junfoot/STM32F407_Muscle/Requirements.md

参考“烧录固件引脚清单.md”，完成STM32嵌入式程序设计
- cubemx产生的ioc文件要同步更新
- 两块AD7606同步采样，量程为正负5V，采样频率2000hz
- AD7606 两片均使用 5V 模拟供电，但输入量程由 RANGE 引脚决定；当前 PC5、PD13 均为低电平，对应输入范围 -5V～+5V。串口电压按 `int16_adc × 5 / 32768` 换算。
- 开启当前连接的这块DAC
- 通过串口USART1实时发送16个通道的ADC数值
- 通过串口指令发送DAC要输出的值
- 保证各功能正常运行，不要阻塞
- 参考文件中使用了但在这没提的功能不用加
- 完成后git本地进行版本管理

补充1
- 将printf函数重定向到usart1
- DAC实际使用的【安富莱】DAC8563_DAC模块 ，输出映射到了0-10V
- 参考工程STM32F407_9011RF，集成IMU读取功能，并实时通过串口输出。这个频率应该低于ADC输出，同步到2000hz后，中间不变的值保持一样即可。一共有0-3号4颗IMU
- IMU参数发送三个角度、三个加速度即可
- 管理好优先级，一般ADC优先级会高，不要发生阻塞
- 串口下发的指令用易写的字符串形式
- USART1命令接收使用Receive-to-IDLE DMA和软件环形缓冲，避免高优先级ADC中断期间丢失字符
- 串口上传格式：采样数据解析#
数据格式#
#define CH_COUNT 通道数量
struct Frame {
    float fdata[CH_COUNT];
    unsigned char tail[4]{0x00, 0x00, 0x80, 0x7f};
};
fdata为小端浮点数组，里面放着需要发送的CH_COUNT个数据。
tail为帧尾。
发送4个曲线的数据长这个样子
bf 10 59 3f b1 02 95 3e 57 a6 16 be 7b 4d 7f bf 00 00 80 7f

补充2
- 串口显示100hz，包括sd卡与usb连接状态，dac输出值，adc采样值，imu数据；第一位状态值bit0表示检测到SD卡、bit1表示USB已连接
- 通过pa15按键控制sd卡写入，led灯指示写入状态

补充3
- 上电时只检测SD卡，不自动创建文件或开始记录
- 按下PA15按键或收到串口`REC START`命令后才开始SD卡记录
