junfoot/STM32F407_Muscle/Ref_project/STM32F407VET6_ADS1292/SD_DATA/20260916/analysis_results/report_5_7.md

# 第 5–7 组步态数据初步分析

## 数据与方法

- 第5组：平地行走；第6组：下楼梯；第7组：上楼梯。
- sEMG1/2 分别为左/右竖脊肌；IMU0/1/2 分别位于左大腿、右大腿、尾椎骨。
- 用三枚 IMU 的角速度模长和动态加速度模长联合识别持续运动区间，排除头尾静止与短促拿放冲击。绿色区域见总览图。
- 肌电采用已有 18 Hz 高通 + 50 Hz 梳状陷波结果，再计算 100 ms RMS 包络；只在自动识别的活动窗内统计。原转换流程已先删除滤波后的前 1 s，进一步减弱了零初值瞬态。
- 为降低安装轴不一致的影响，IMU 比较采用三轴向量模长、三轴协方差特征值以及各传感器自己的 PCA 主运动轴；没有把不同传感器的同名单轴直接相减。

## 自动分段与主要指标

|组别|工况|活动区间 (s)|时长 (s)|左EMG RMS (µV)|右EMG RMS (µV)|双侧差异 (%)|包络相关|步频 (步/min)|尾椎动态加速度 RMS (g)|
|---:|---|---:|---:|---:|---:|---:|---:|---:|---:|
|5|平地行走|5.1–20.3|15.2|68.5|97.0|34.3|0.53|106.2|0.229|
|6|下楼梯|3.0–10.7|7.8|27.5|32.4|16.3|0.25|98.3|0.259|
|7|上楼梯|3.2–10.5|7.3|42.7|68.6|46.4|0.01|101.5|0.242|

## 相对平地的变化

- 下楼梯：左/右竖脊肌 RMS 相对平地分别为 -59.9% / -66.6%；尾椎动态加速度 RMS 为 +12.9%。
- 上楼梯：左/右竖脊肌 RMS 相对平地分别为 -37.7% / -29.3%；尾椎动态加速度 RMS 为 +5.4%。

## 可以支持的初步结论

1. 三种任务的竖脊肌负荷、左右协同性、步频及躯干动态冲击可以进行定量比较；具体数值以上表和 CSV 为准。
2. 单轴波形不能跨 IMU 直接比较，因为安装姿态差异会把同一身体运动投影到不同轴；本分析的模长/PCA 结果更适合当前数据。
3. 大腿角速度的第一主成分方差占比可衡量运动是否近似集中在一个主旋转轴；占比高时，PCA 主轴信号可作为近似屈伸波形，但仍不是解剖学关节角。
4. 当前只有每种工况一次、同一受试者的一段记录，没有 MVC 归一化、足接触事件或安装标定，因此只能作为描述性个案结果，不能做组间统计推断，也不宜把原始 µV 直接解释为普遍的肌肉负荷大小。

## 质量控制与后续建议

- 对齐文件显示 EMG 序列连续、无缺样；但 IMU 插值最近源样本距离的最大值在部分通道达到约 0.1–0.36 s。应查看原始时间戳，把源样本距离过大的区间标为低可信，而不是把插值曲线当作真实高频采样。
- 正式采集前做 5–10 s 静止站立标定，记录每个 IMU 的安装方向；若要算髋/躯干角，建议保存四元数并用传感器到解剖坐标系的标定旋转矩阵变换。
- 增加同步脚踏开关或足部 IMU，明确脚跟着地/离地事件；每工况至少重复多次，并采集 MVC，之后可做步态周期归一化和统计检验。

## 输出文件

- `metrics_5_7.csv`：完整数值指标。
- `overview_5_7.png`：EMG 包络、三枚 IMU 角速度模长与自动活动窗。
- `analysis_parameters.json`：关键参数，便于复现。
