junfoot/STM32F407_Muscle/Ref_project/STM32F407VET6_ADS1292/SD_DATA/20260916/analysis.md

分析5-7组数据能得到什么结论
- 5：平地行走
- 6：下楼梯
- 7：上楼梯
- sEMG1：左竖脊肌（后腰）
- sEMG2：右竖脊肌（后腰）
- IMU0：左侧大腿前侧
- IMU1：右侧大腿前侧
- IMU2：尾椎骨处
- 数据头尾未在行走。肌电信号由于滤波头部有震荡
- IMU的轴可能并不是很对齐，有没有什么方法分析

## 分析进展（2026-09-16）

已完成第 5–7 组的首轮可重复分析：自动排除头尾非行走段，计算双侧竖脊肌 RMS 包络、步频、三枚 IMU 的角速度/动态加速度指标，并用三轴模长与 PCA 主运动轴降低安装轴不对齐的影响。

初步结果：

- 自动识别的主要活动窗：第5组 5.11–20.26 s，第6组 2.95–10.74 s，第7组 3.20–10.47 s。
- 步频约为 106.2、98.3、101.5 步/min（依次为平地、下楼、上楼）。
- 本次记录中，上楼的双侧竖脊肌 RMS 高于下楼，但平地最高；由于每种工况只有一次记录且没有 MVC 归一化，这一现象只能作为个案描述，不能直接外推为普遍生理结论。
- 尾椎动态加速度 RMS：下楼最高（0.259 g），上楼次之（0.242 g），平地最低（0.229 g），提示本次下楼的躯干动态冲击更大。
- IMU 不宜跨传感器直接比较同名单轴。当前采用旋转不变的三轴模长、协方差特征值和各传感器自身 PCA 主轴；若需解剖学关节角，后续必须增加静态姿态/安装方向标定。

完整结果见 [`analysis_results/report_5_7.md`](analysis_results/report_5_7.md)，数值表见 [`analysis_results/metrics_5_7.csv`](analysis_results/metrics_5_7.csv)，复现脚本为 [`analyze_gait_5_7.py`](analyze_gait_5_7.py)。

## 躯干肌电能否比下肢肌电提供更多信息？

### 结论先行

**不能根据本批数据证明“躯干肌电比下肢肌电信息更多”。** 本批实验只测了左右竖脊肌，没有同步测量任何下肢肌肉，因此缺少同一受试者、同一动作、同一步态周期下的直接对照。更准确的结论是：

- 对**躯干稳定、腰椎负荷、左右代偿、姿势控制及低背痛相关控制策略**，躯干肌电通常比下肢肌电更直接。
- 对**步态相位、足部离地/着地、髋膝踝做功、推进与制动、上/下楼意图**，多块下肢肌电通常更直接，也往往具有更高的任务识别能力。
- 若目标是理解完整步态机制，二者是**互补信息**，不存在与任务无关的绝对“谁更多”。本系统目前的两路竖脊肌 EMG 更适合作为下肢 IMU/未来下肢 EMG 的补充通道，而不是替代下肢 EMG。

### 本批数据实际支持什么

将左右竖脊肌 RMS 取算术平均后，平地、下楼、上楼分别约为 **82.7、30.0、55.7 µV**。三个任务同时呈现不同的双侧模式：

|工况|双侧平均 RMS (µV)|左右不对称 (%)|左右包络零时滞相关|骶骨动态加速度 RMS (g)|
|---|---:|---:|---:|---:|
|平地|82.7|34.3|0.53|0.229|
|下楼|30.0|16.3|0.25|0.259|
|上楼|55.7|46.4|0.01|0.242|

这里最值得关注的不是原始幅值排序，而是 **EMG 与运动冲击的排序不一致**：下楼时骶骨动态加速度最高而竖脊肌 RMS 最低，平地则相反。这说明竖脊肌 EMG 没有简单重复 IMU 的“运动强度”，而可能包含额外的神经肌肉控制信息，例如躯干刚度调节、左右稳定策略和姿势代偿。上楼时较大的左右不对称也值得复测。

不过，这些结果还不能被解释成确定的生理差异，原因包括：每个工况只有一次记录、每段时长不同、没有 MVC 归一化、没有逐步态周期对齐，也没有控制速度、扶手使用、领先腿、楼梯高度和负重。若三次记录之间重新贴过电极，原始 µV 幅值甚至不应直接跨记录比较。

另外，表中的“左右包络相关”是**零时滞相关**。上楼的 0.01 不等于左右肌肉“没有协同”；左右交替、周期相位差、少量时间错位都会显著降低该指标。正式结论应在可靠的足接触事件或步态周期基础上，计算允许时滞的互相关、周期归一化波形相似度及共同激活指数。

### 为什么两类 EMG 回答的是不同问题

|研究问题|更优先的信号|原因|
|---|---|---|
|平地/上楼/下楼识别，步态相位与运动意图|下肢多肌群 EMG|股四头肌、腘绳肌、胫前肌、腓肠肌/比目鱼肌直接参与支撑、推进、制动和摆动；楼梯上升与下降的关节功和募集模式明显不同。|
|髋、膝、踝功能障碍定位|下肢 EMG + 关节运动学/力学|能够把异常募集对应到具体关节和步态阶段。|
|躯干稳定、腰背负荷和姿势代偿|双侧/多部位躯干 EMG|竖脊肌和腹肌直接反映轴向稳定与共同收缩；单纯下肢 EMG 难以定位腰背控制策略。|
|左右躯干不对称、脊柱疾病或低背痛表型|躯干阵列 EMG|相关研究在脊柱不稳、脊柱侧弯和持续性低背痛中观察到椎旁肌幅值、时序与左右协调的改变。|
|绊倒、外扰和负重下的全身稳定反应|躯干 EMG + 下肢 EMG + IMU|躯干反射负责快速稳定上身，下肢随后通过落脚位置、支撑和推进恢复平衡。|

这也解释了当前结果为何没有呈现“上/下楼竖脊肌一定高于平地”的简单关系：楼梯任务对**下肢正/负机械功**的增加很明确，但竖脊肌幅值取决于躯干姿势、速度、个体稳定策略和测量归一化，不能用下肢做功规律直接替代。

### 怎样在下一批实验中真正比较“信息量”

建议保留当前左右竖脊肌，同时至少增加双侧以下四类下肢肌肉：股直肌或股外侧肌、股二头肌、胫骨前肌、腓肠肌内侧头或比目鱼肌。若通道有限，优先保留双侧竖脊肌，再用 4–6 个下肢通道覆盖髋/膝/踝功能，而不是只测同一关节周围的多块相近肌肉。

实验与统计应采用：

1. 每工况至少 5–10 次独立重复，记录平地、上楼、下楼、转弯、扰动/负重等任务；同步足部 IMU 或脚踏开关。
2. 电极位置按 SENIAM 思路固定并记录，采集 MVC 或任务内参考收缩，使用 `%MVC` 或每受试者稳健标准化；固定楼梯高度、速度、领先腿与是否扶扶手。
3. 以完整步态周期为样本，分别建立三组模型：`IMU`、`IMU + 下肢 EMG`、`IMU + 下肢 EMG + 躯干 EMG`。
4. 采用**按受试者/按整次试验分组的交叉验证**，禁止把同一次记录切成相邻窗口后随机分到训练集和测试集，否则会产生严重数据泄漏。
5. 用宏平均 F1、交叉熵或条件互信息衡量增益：
   - 下肢 EMG 增益：`模型(IMU+下肢) − 模型(IMU)`；
   - 躯干 EMG 的独立增益：`模型(IMU+下肢+躯干) − 模型(IMU+下肢)`。
   只有后一项在独立测试中稳定为正，才能说躯干 EMG 提供了下肢信号没有覆盖的信息；若其增益还显著大于前一项，才有依据说在**指定任务和指标下**“躯干 EMG 更多”。

### 对当前系统的判断

当前两路竖脊肌已经显示出值得保留的补充价值，尤其是左右不对称与“肌肉募集—躯干冲击”不一致的信息。但仅靠两路竖脊肌，不足以解释下肢各关节的推进、制动和做功，也不足以可靠识别完整步态相位。若研究重点是外骨骼控制或上下楼意图识别，下肢 EMG 应是优先扩展方向；若重点是腰背代偿、姿势稳定、低背痛或脊柱不对称，躯干 EMG 则可能是更有价值的主信号。

### 文献依据

- Peng 等发现进入楼梯前的下肢运动学和 EMG 已出现预期性改变，支持下肢 EMG 用于楼梯转换/意图识别：[J Biomech, 2016](https://pubmed.ncbi.nlm.nih.gov/26830440/)。
- Koopman 等对平地、楼梯及其转换的研究显示，楼梯任务的下肢关节功、做功及主要肌群 EMG 随任务和坡度系统改变：[PLOS ONE, 2023](https://pmc.ncbi.nlm.nih.gov/articles/PMC10653464/)。
- 一项包含 50 名健康受试者的公开数据研究同时采集下肢运动学、动力学和主要下肢肌群 EMG，说明这些信号适合刻画不同步行与楼梯任务：[Scientific Data, 2019](https://pmc.ncbi.nlm.nih.gov/articles/PMC6897988/)。
- Smith 等的系统综述与荟萃分析显示，持续性低背痛人群步行时椎旁肌激活幅值及躯干协调可发生改变，说明躯干 EMG 对腰背控制表型具有针对性信息：[J Sport Health Sci, 2022](https://pmc.ncbi.nlm.nih.gov/articles/PMC9338341/)。
- 突发行走扰动研究用多通道躯干 EMG 识别神经肌肉反射与姿势反应，提示躯干 EMG 对稳定性/扰动问题的价值：[Eur Spine J, 2017](https://pmc.ncbi.nlm.nih.gov/articles/PMC5358879/)。
