junfoot/STM32F407_Muscle/Ref_project/STM32F407_9011RF/9011rf.md

                                                                                                                          

# 产品介绍
## 产品概述
+ 产品模组由1个主机和若干个从机组成，最多可连接32个从机。
+ <font style="color:#181818;">从机集成高精度的陀螺仪、加速度计、地磁场传感器，采用高性能的微处理器和先进的动力学解算与卡尔曼动态滤波算法，能够快速求解出从机当前的实时运动姿态。</font>
+ <font style="color:#181818;">采用先进的数字滤波技术，能有效降低测量噪声，提高测量精度。</font>
+ <font style="color:#181818;">从机内部集成了姿态解算器，配合动态卡尔曼滤波算法，能够在动态环境下准确输出从机的当前姿态，姿态测量精度0.2度，稳定性极高，性能甚至优于某些专业的倾角仪！</font>
+ <font style="color:#181818;">高性能cortex-M4内核处理器运行主频高达168MHZ，兼顾低功耗与高性能。</font>
+ <font style="color:#181818;">射频2.4G无线传输，传输速率快，最高有效速率可达256kbps。</font>

## 产品特点
+ <font style="color:black;background-color:#FFFFFF;">从机</font><font style="color:black;background-color:#FFFFFF;">集成高精度的陀螺仪、加速度计、地磁场传感器，采用高性能的微处理器和先进的动力学解算与卡尔曼动态滤波算法，能够快速求解出模块当前的实时运动姿态。</font>
+ <font style="color:black;background-color:#FFFFFF;">采用先进的数字滤波技术，能有效降低测量噪声，提高测量精度。</font>
+ <font style="color:black;background-color:#FFFFFF;">从机</font><font style="color:black;background-color:#FFFFFF;">内部集成了姿态解算器，配合动态卡尔曼滤波算法，能够在动态环境下准确输出模块的当前姿态，姿态测量精度0.2°，稳定性极高，性能甚至优于某些专业的倾角仪。</font>
+ <font style="color:black;background-color:#FFFFFF;">Z轴航向角加入地磁传感器滤波融合，解决了6轴算法中，由于陀螺仪积分的漂移引起的累计误差，可长期稳定输出航向角数据。</font>**<font style="color:black;background-color:#FFFFFF;">注意：要由于有磁场检测，使用前需要校准，而且使用时需要远离磁干扰区域、电子设备、磁铁、扬声器等硬磁性物体至少20cm的距离。</font>**
+ <font style="color:rgb(24, 24, 24);">工作电流：≈  15mA，待机电流  13uA。</font>
+ <font style="color:rgb(24, 24, 24);">数据接口：波特率460800。</font>
+ <font style="color:black;background-color:#FFFFFF;">输出内容包含三轴加速度、三轴角速度、三轴磁场、三轴角度、从机电量</font><font style="color:#181818;">。</font>
+ <font style="color:black;background-color:#FFFFFF;">4层PCB板工艺，更薄、更小、更可靠。</font>
+ <font style="color:#181818;">2.4G射频无线传输</font>

# <font style="color:black;background-color:#FFFFFF;">参数指标</font>
## <font style="color:black;background-color:#FFFFFF;">加速度计参数</font>
| 参数 | 条件 | 典型值 |
| :---: | --- | :---: |
| 量程 |  | ±16g |
| 分辨率 | ±16g | 0.0005(g/LSB) |
| 采样率 |  | 1KHZ |
| RMS噪声 | 带宽=100Hz | 0.75~1mg-rms |
| 静止零漂 | 水平放置 | ±20~40mg |
| 温漂 | -40°C ~ +85°C | ±0.15mg/℃ |
| 带宽 |  | 5~256Hz |

## 陀螺仪参数
| 参数 | 条件 | 典型值 |
| :---: | :---: | :---: |
| 量程 |  | ±2000°/s |
| 分辨率 | ±2000°/s | 0.061(°/s)/(LSB) |
| 采样率 |  | 1KHZ |
| RMS噪声 | 带宽=100Hz | 0.028~0.07(°/s)-rms |
| 静止零漂 | 水平放置 | ±0.5~1°/s |
| 温漂 | -40°C ~ +85°C | ±0.005~0.015 (°/s)/℃ |
| 带宽 |  | 5~256Hz |

## 磁力计参数
| 参数 | 条件 | 典型值 |
| :---: | :---: | :---: |
| 量程 |  | ±2Gauss |
| 分辨率 | ±2Gauss | 0.0667mGauss/LSB |

## 俯仰、横滚角参数
| 参数 | 条件 | 典型值 |
| :---: | :---: | :---: |
| 量程 |  | X:±180° |
| | | Y:±90° |
| 倾角精度 |  | 0.2° |
| 分辨率 | 水平放置 | 0.0055° |
| 温漂 | -40°C ~ +85°C | ±1° |

## 航向角参数
| 参数 | 条件 | 典型值 |
| :---: | :---: | :---: |
| 量程 | | Z:±180° |
| 航向精度 | 9轴算法，磁场校准，动/静态 | 1°（不受磁场干扰情况下）【1】 |
| | 6轴算法，静态 | 0.5°（动态存在积分累计误差）<br/>【2】 |
| 分辨率 | 水平放置 | 0.0055° |

注：

【1】使用前请在测试的环境进行磁场校准，确保传感器熟悉该环境下的磁场，校准时，请远离磁干扰【2】在有些震动环境下，会有累计误差，具体误差不可估计，具体根据实际测试为准

## 模组参数
### 基本参数
| <font style="color:black;">参数</font> | <font style="color:black;">条件</font> | <font style="color:black;">最小值</font> | <font style="color:black;">默认</font> | <font style="color:black;">最大值</font> |
| :---: | --- | --- | --- | :---: |
| <font style="color:black;">通信接口</font> | <font style="color:black;">UART</font> | <font style="color:black;">460800bps</font> | <font style="color:black;">460800bps</font> | <font style="color:black;">460800bps</font> |
| <font style="color:black;">输出内容</font> |  | <font style="color:black;">3轴加速度、3轴角速度、3轴磁场、3轴角度</font> | | |
| <font style="color:black;">输出速率</font> | 连接10个以内 | <font style="color:black;"></font> | <font style="color:black;">30HZ</font> | <font style="color:black;"></font> |
| <font style="color:black;">启动时间</font> |  |  |  | <font style="color:black;">1000ms</font> |
| <font style="color:black;">级联数量</font> | <font style="color:black;">射频</font><font style="color:black;">多联适配器</font> | 1 | 16 | <font style="color:black;">32个</font> |
| <font style="color:#181818;">无线</font><font style="color:#181818;">传输距离</font> | <font style="color:#181818;">空旷环境</font> |  | <font style="color:black;">50m</font> | <font style="color:black;">90m</font> |
| <font style="color:#181818;">重量</font> | <font style="color:#181818;"></font> |  | <font style="color:black;">8.67g</font> | <font style="color:black;"></font> |
| <font style="color:black;">工作温度</font> |  | <font style="color:black;">-20</font><font style="color:black;">℃</font> |  | <font style="color:black;">60</font><font style="color:black;">℃</font> |
| <font style="color:#4d4d4d;">存储温度</font> |  | <font style="color:#4d4d4d;">-40</font><font style="color:black;">℃</font> |  | <font style="color:#4d4d4d;">85</font><font style="color:black;">℃</font> |
| <font style="color:black;">耐冲击</font> |  |  |  | <font style="color:black;">20000g</font> |

### 电气参数
| 参数 | 条件 | 最小值 | 默认 | 最大值 |
| :---: | :---: | --- | :---: | :---: |
| 充电电压 |  |  | 5V |  |
| 电池电压 |  |  | 3.7V |  |
| 工作电流 |  |  | 15mA |  |
| 广播电流 |  |  |  |  |
| 待机电流 |  |  | 13uA |  |
| 电池容量 |  |  | 130mAH |  |
| 功耗 |  |  | 55.5mW |  |
| 工作时长 |  |  |  | 8小时 |
| 充电时长 |  |  |  | 2小时 |

# 上位机连接
## <font style="color:rgb(51, 51, 51);">CH340驱动安装 </font>
<font style="color:rgb(51, 51, 51);">通过Type-c连接上电脑，打开上位机，安装好串口模块对应的CH340驱动(</font>[CH340驱动下载](https://witpic-1253369323.cos.ap-guangzhou.myqcloud.com/soft/CH340%E9%A9%B1%E5%8A%A8.rar)<font style="color:rgb(51, 51, 51);">)以后，可以在设备管理器中查询到对应的端口号，如图所示：</font>

## 适配器连接与配置
1.先把适配器跟电脑进行连接（只有适配器需要直连电脑）



2.<font style="color:rgb(51, 51, 51);">打开维特</font>[**智能上位机**](https://wit-motion.yuque.com/wumwnr/aqvq6y/qngktvx5grz81zkq)<font style="color:rgb(51, 51, 51);">软件。</font>

①<font style="color:rgb(51, 51, 51);">选择WT9011DCL-RF的型号。</font>

<font style="color:rgb(51, 51, 51);">②点击搜索设备。</font>

<font style="color:rgb(51, 51, 51);">③勾选Master连接适配器。</font>

<font style="color:rgb(51, 51, 51);">④打开配置界面。</font>

<font style="color:rgb(51, 51, 51);">⑤确认配置界面是否“在线”，“在线”的情况下进行下一步。</font>

<font style="color:rgb(51, 51, 51);">⑥修改主机配置的从机数量，Master配置的从机数量可以大于实际要连接的从机数量，假如只有2个从机，从机数量可以配置为6或者大于6~32的任意数字，但不能低于6，假如有10个从机，从机数量可以配置为10。</font>

<font style="color:rgb(51, 51, 51);">⑦设置保存。</font>



## 从机连接与配置
1.从机按开机键进行开机，开机后会闪烁绿灯，如果开机指示灯没有反应请充电后再试。

<font style="color:#DF2A3F;">注：第1次使用的时候从机单个开机依次进行配置，不要一次性把所有从机都开机，不然无法进行配置。</font>



<font style="color:rgb(51, 51, 51);">2.打开维特</font>[**智能上位机**](https://wit-motion.yuque.com/wumwnr/aqvq6y/qngktvx5grz81zkq)<font style="color:rgb(51, 51, 51);">软件。</font>

①<font style="color:rgb(51, 51, 51);">选择WT9011DCL-RF的型号。</font>

<font style="color:rgb(51, 51, 51);">②点击搜索设备。</font>

<font style="color:rgb(51, 51, 51);">③勾选Master连接适配器。</font>

<font style="color:rgb(51, 51, 51);">④勾选从机。</font>

<font style="color:rgb(51, 51, 51);">⑤第1次连接的时候，所有从机ID都是01，所以第1次配置时只勾选01的从机ID，然后打开配置界面。</font>

<font style="color:rgb(51, 51, 51);">⑥确认配置界面是否“在线”，“在线”的情况下进行下一步。</font>

<font style="color:rgb(51, 51, 51);">⑦连接多个从机的时候，需要修改默认ID，ID配置范围0~31，即00、01、02......30、31。</font>

<font style="color:#DF2A3F;">注：搜索设备会出现多个设备选项，只需要关注id为01的设备即可，所有从机出厂时设备id默认都为01。</font>



⑧配置其他从机重复①-⑦步骤，再进行第2个从机配置时同样勾选01进行配置，修改设备ID即可。

⑨配置好所有从机后重新进行搜索，勾选Master和相应从机ID就可以显示数据。

# 产品尺寸



# 接口定义
## 接口说明
| 接口名称 | | 接口功能 |
| :---: | --- | :---: |
| <font style="color:black;">主机</font><font style="color:black;">TYPE-C</font> | | <font style="color:black;">充电及串口输出</font><font style="color:black;">【1】</font> |
| <font style="color:black;">从机TYPE-C</font> | | <font style="color:black;">充电</font> |

注：

【1】支持TYPE-C连接PC查看数据，PC端需要安装CH340驱动。

# 产品包装
## 样品包装



# <font style="color:black;background-color:#FFFFFF;">应用领域</font>
+ <font style="color:black;background-color:#FFFFFF;">虚拟现实/增强现实，头戴显示器</font>
+ <font style="color:black;background-color:#FFFFFF;">大规模农业自动耕种</font>
+ <font style="color:black;background-color:#FFFFFF;">高空作业安全监控</font>
+ <font style="color:black;background-color:#FFFFFF;">工业姿态监控</font>
+ <font style="color:black;background-color:#FFFFFF;">人体动作跟踪/捕捉</font>
+ <font style="color:black;background-color:#FFFFFF;">机器人，自动引导运输车</font>
+ <font style="color:black;background-color:#FFFFFF;">行人导航</font>
+ <font style="color:black;background-color:#FFFFFF;">无人驾驶/辅助驾驶</font>

##
