junfoot/STM32F407_Muscle/Ref_project/STM32F407_9011RF/9011RF通讯协议.md

# <font style="color:rgb(0,0,0);">RF传输模式</font>
从机——>主机		（射频信号传输）

主机——>上位机	（串口传输）

**<font style="color:rgb(0,0,0);">主机到上位机默认上传 Flag=0x61(加速度 角速度 磁场 角度 电量)的数据。 </font>**

**<font style="color:rgb(0,0,0);">Flag=0x71 需要发送读取对应寄存器指令才能回传。 </font>**

**<font style="color:rgb(0,0,0);"></font>**

# <font style="color:rgb(0,0,0);">加速度 角速度 磁场 角度 电量数据包（默认）</font>
| 设备号<br/><font style="color:rgb(0,0,0);">1Byte</font> | <font style="color:rgb(0,0,0);">数据包头 </font><br/><font style="color:rgb(0,0,0);">1Byte</font> | <font style="color:rgb(0,0,0);">标志位 </font><br/><font style="color:rgb(0,0,0);">1Byte</font> | <font style="color:rgb(0,0,0);">axL</font> | <font style="color:rgb(0,0,0);">axH</font> | ...... | <font style="color:rgb(0,0,0);">YawL</font> | <font style="color:rgb(0,0,0);">YawH</font> | <font style="color:rgb(0,0,0);">BatPerL</font> | <font style="color:rgb(0,0,0);">BatPerH</font> |
| --- | --- | --- | --- | --- | --- | --- | --- | --- | --- |
| 0xNN | <font style="color:rgb(0,0,0);">0x55</font> | Flag | 0xNN | 0xNN | ...... | 0xNN | 0xNN | 0xNN | 0xNN |

<font style="color:rgb(0,0,0);">注：0xNN 是收到的具体数值,数据回传顺序为加速度 X Y Z，角速度 X Y Z,磁场 XYZ, 角度 XYZ, 电池电量</font>

<font style="color:rgb(0,0,0);">低字节在前，高字节在后。 </font>

<font style="color:rgb(0,0,0);">Flag = 0x61 数据内容 26Bytes 为加速度，角速度,  磁场，角度, 电池电量</font>

| <font style="color:rgb(0,0,0);">0xNN</font> | 设备号 |
| --- | --- |
| <font style="color:rgb(0,0,0);">0x55 </font> | <font style="color:rgb(0,0,0);">数据包头</font> |
| <font style="color:rgb(0,0,0);">0x61 </font> | <font style="color:rgb(0,0,0);">标志位 </font> |
| <font style="color:rgb(0,0,0);">axL </font> | <font style="color:rgb(0,0,0);">X 轴加速度低 8 位 </font> |
| <font style="color:rgb(0,0,0);">axH </font> | <font style="color:rgb(0,0,0);">X 轴加速度高 8 位 </font> |
| <font style="color:rgb(0,0,0);">ayL </font> | <font style="color:rgb(0,0,0);">Y 轴加速度低 8 位</font> |
| <font style="color:rgb(0,0,0);">ayH </font> | <font style="color:rgb(0,0,0);">Y 轴加速度高 8 位</font> |
| <font style="color:rgb(0,0,0);">azL </font> | <font style="color:rgb(0,0,0);">Z 轴加速度低 8 位</font> |
| <font style="color:rgb(0,0,0);">azH </font> | <font style="color:rgb(0,0,0);">Z 轴加速度高 8 位 </font> |
| <font style="color:rgb(0,0,0);">wxL </font> | <font style="color:rgb(0,0,0);">X 轴角速度低 8 位 </font> |
| <font style="color:rgb(0,0,0);">wxH</font> | <font style="color:rgb(0,0,0);">X 轴角速度高 8 位</font> |
| <font style="color:rgb(0,0,0);">wyL </font> | <font style="color:rgb(0,0,0);">Y 轴角速度低 8 位</font> |
| <font style="color:rgb(0,0,0);">wyH</font> | <font style="color:rgb(0,0,0);">Y 轴角速度高 8 位</font> |
| <font style="color:rgb(0,0,0);">wzL </font> | <font style="color:rgb(0,0,0);">Z 轴角速度低 8 位</font> |
| <font style="color:rgb(0,0,0);">wzH </font> | <font style="color:rgb(0,0,0);">Z 轴角速度高 8 位</font> |
| <font style="color:rgb(0,0,0);">hxL </font> | <font style="color:rgb(0,0,0);">X 轴磁场低 8 位 </font> |
| <font style="color:rgb(0,0,0);">hxH</font> | <font style="color:rgb(0,0,0);">X 轴磁场高 8 位</font> |
| <font style="color:rgb(0,0,0);">hyL </font> | <font style="color:rgb(0,0,0);">Y 轴磁场低 8 位</font> |
| <font style="color:rgb(0,0,0);">hyH</font> | <font style="color:rgb(0,0,0);">Y 轴磁场高 8 位</font> |
| <font style="color:rgb(0,0,0);">hzL </font> | <font style="color:rgb(0,0,0);">Z 轴磁场低 8 位</font> |
| <font style="color:rgb(0,0,0);">hzH </font> | <font style="color:rgb(0,0,0);">Z 轴磁场高 8 位</font> |
| <font style="color:rgb(0,0,0);">RollL </font> | <font style="color:rgb(0,0,0);">X 轴角度低 8 位</font> |
| <font style="color:rgb(0,0,0);">RollH </font> | <font style="color:rgb(0,0,0);">X 轴角度高 8 位</font> |
| <font style="color:rgb(0,0,0);">PitchL</font> | <font style="color:rgb(0,0,0);">Y 轴角度低 8 位 </font> |
| <font style="color:rgb(0,0,0);">PitchH </font> | <font style="color:rgb(0,0,0);">Y 轴角度高 8 位</font> |
| <font style="color:rgb(0,0,0);">YawL</font> | <font style="color:rgb(0,0,0);">Z 轴角度低 8 位</font> |
| <font style="color:rgb(0,0,0);">YawH </font> | <font style="color:rgb(0,0,0);">Z 轴角度高 8 位</font> |
| <font style="color:rgb(0,0,0);">BatPerL</font> | <font style="color:rgb(0,0,0);">从机电池电量低八位</font> |
| <font style="color:rgb(0,0,0);">BatPerH</font> | <font style="color:rgb(0,0,0);">从机电池电量高八位</font> |

### <font style="color:rgb(0,0,0);">加速度计算方法：单位 g </font>
<font style="color:rgb(0,0,0);">a</font><font style="color:rgb(0,0,0);">x</font><font style="color:rgb(0,0,0);">=((axH<<8)|axL)/32768*16g(g </font><font style="color:rgb(0,0,0);">为重力加速度，可取 </font><font style="color:rgb(0,0,0);">9.8m/s</font><font style="color:rgb(0,0,0);">2</font><font style="color:rgb(0,0,0);">) </font>

<font style="color:rgb(0,0,0);">a</font><font style="color:rgb(0,0,0);">y</font><font style="color:rgb(0,0,0);">=((ayH<<8)|ayL)/32768*16g(g </font><font style="color:rgb(0,0,0);">为重力加速度，可取 </font><font style="color:rgb(0,0,0);">9.8m/s</font><font style="color:rgb(0,0,0);">2</font><font style="color:rgb(0,0,0);">) </font>

<font style="color:rgb(0,0,0);">a</font><font style="color:rgb(0,0,0);">z</font><font style="color:rgb(0,0,0);">=((azH<<8)|azL)/32768*16g(g </font><font style="color:rgb(0,0,0);">为重力加速度，可取 </font><font style="color:rgb(0,0,0);">9.8m/s</font><font style="color:rgb(0,0,0);">2</font><font style="color:rgb(0,0,0);">) </font>

<font style="color:rgb(0,0,0);"></font>

### <font style="color:rgb(0,0,0);">角速度计算方法：单位 °/s</font>
<font style="color:rgb(0,0,0);">w</font><font style="color:rgb(0,0,0);">x</font><font style="color:rgb(0,0,0);">=((wxH<<8)|wxL)/32768*2000(°/s) </font>

<font style="color:rgb(0,0,0);">w</font><font style="color:rgb(0,0,0);">y</font><font style="color:rgb(0,0,0);">=((wyH<<8)|wyL)/32768*2000(°/s) </font>

<font style="color:rgb(0,0,0);">w</font><font style="color:rgb(0,0,0);">z</font><font style="color:rgb(0,0,0);">=((wzH<<8)|wzL)/32768*2000(°/s) </font>

<font style="color:rgb(0,0,0);"></font>

### <font style="color:rgb(0,0,0);">角度计算方法：单位 ° </font>
<font style="color:rgb(0,0,0);">滚转角（x 轴）Roll=((RollH<<8)|RollL)/32768*180(°) </font>

<font style="color:rgb(0,0,0);">俯仰角（y 轴）Pitch=((PitchH<<8)|PitchL)/32768*180(°) </font>

<font style="color:rgb(0,0,0);">偏航角（z 轴）Yaw=((YawH<<8)|YawL)/32768*180(°) </font>

<font style="color:rgb(0,0,0);"></font>

### <font style="color:rgb(0,0,0);">磁场输出：单位uT</font>
注：原始数据计算得出来的磁场数据单位是毫高斯，和电脑上位机显示的单位是不一样的，<font style="color:#DF2A3F;">如果需要转换和上位机一样的单位需要根据下面这个计算方式去计算。</font>

**1.**[**磁场原始数据单位转换公式链接**](https://wit-motion.yuque.com/wumwnr/docs/ggh1nyqhkg0gyk43?singleDoc#)

| <font style="color:rgb(0,0,0);">0x55 </font> | <font style="color:rgb(0,0,0);">0x71</font> | <font style="color:rgb(0,0,0);">0x3A </font> | <font style="color:rgb(0,0,0);">0x00 </font> | <font style="color:rgb(0,0,0);">HxL </font> | <font style="color:rgb(0,0,0);">HxH</font> | <font style="color:rgb(0,0,0);">HyL </font> | <font style="color:rgb(0,0,0);">HyH </font> | <font style="color:rgb(0,0,0);">HzL </font> | <font style="color:rgb(0,0,0);">HzH.....</font> |
| --- | --- | --- | --- | --- | --- | --- | --- | --- | --- |

<font style="color:rgb(0,0,0);">计算方法：单位 </font><font style="color:rgb(0,0,0);">mG </font>

<font style="color:rgb(0,0,0);">磁场（x 轴）Hx=(( HxH<<8)| HxL) </font>

<font style="color:rgb(0,0,0);">磁场（y 轴）Hy=(( HyH <<8)| HyL) </font>

<font style="color:rgb(0,0,0);">磁场（z 轴）Hz =(( HzH<<8)| HzL) </font>

<font style="color:rgb(0,0,0);">例：在 </font><font style="color:rgb(0,0,0);">APP </font><font style="color:rgb(0,0,0);">上发送读取磁场指令：</font><font style="color:rgb(0,0,0);">FF AA 27 3A 00</font><font style="color:rgb(0,0,0);">（参考 </font><font style="color:rgb(0,0,0);">7.2.8 </font><font style="color:rgb(0,0,0);">读取寄存器值） </font>

<font style="color:rgb(0,0,0);">模块回传数据至 APP：55 71 3A 00 68 01 69 00 7A 00 00 00 00 00 00 00 00 00 00 00 共 20 个字节。</font>

<font style="color:rgb(0,0,0);">对第 5 至第 10 个字节按上述解算,磁场 x=360，y=105,z=122。</font>

<font style="color:rgb(0,0,0);"></font>

### <font style="color:rgb(0,0,0);">电量输出：单位V</font>
<font style="color:rgb(0,0,0);">电压和电量百分比对应关系为：</font>

| 寄存器值 | 电压值 | 电量百分比 |
| --- | --- | --- |
| >396 | > 3.96V | 100% |
| 393-396 | 3.93V-3.96V | 90% |
| 387-393 | 3.87V-3.93V | 75% |
| 382-387 | 3.82V-3.87V | 60% |
| 379-382 | 3.79V-3.82V | 50% |
| 377-379 | 3.77V-3.79V | 40% |
| 373-377 | 3.73V-3.77V | 30% |
| 370-373 | 3.70V-3.73V | 20% |
| 368-370 | 3.68V-3.70V | 15% |
| 350-368 | 3.50V-3.68V | 10% |
| 340-350 | 3.40V-3.50V | 5% |
| <340 | <3.40V | 0% |

<font style="color:rgb(0,0,0);"></font>

<font style="color:rgb(0,0,0);"></font>

<font style="color:rgb(0,0,0);">注：</font>

<font style="color:rgb(0,0,0);">1. 姿态角结算时所使用的坐标系为东北天坐标系，正方向放置模块,如“4 引脚说明” </font>

<font style="color:rgb(0,0,0);">所示向左为 X 轴，向前为 Y 轴，向上为 Z 轴。欧拉角表示姿态时的坐标系旋转顺序 </font>

<font style="color:rgb(0,0,0);">定义为为 Z-Y-X,即先绕 Z 轴转，再绕 Y 轴转，再绕 X 轴转。 </font>

<font style="color:rgb(0,0,0);">2. 滚转角的范围虽然是±180 度，但实际上由于坐标旋转顺序是 Z-Y-X，在表示姿态 </font>

<font style="color:rgb(0,0,0);">的时候，俯仰角(Y 轴)的范围只有±90 度，超过 90 度后会变换到小于 90 度，同时 </font>

<font style="color:rgb(0,0,0);">让X轴的角度大于180度。详细原理请大家自行百度欧拉角及姿态表示的相关信息。 </font>

<font style="color:rgb(0,0,0);">3. 由于三轴是耦合的，只有在小角度的时候会表现出独立变化，在大角度的时候姿态 </font>

<font style="color:rgb(0,0,0);">角度会耦合变化，比如当 Y 轴接近 90 度时，即使姿态只绕 Y 轴转动，X 轴的角度 </font>

<font style="color:rgb(0,0,0);">也会跟着发生较大变化，这是欧拉角表示姿态的固有特性。 </font>

<font style="color:rgb(0,0,0);"></font>

<font style="color:rgb(0,0,0);">说明： </font>

<font style="color:rgb(0,0,0);">1</font><font style="color:rgb(0,0,0);">、 数据是按照 </font><font style="color:rgb(0,0,0);">16 </font><font style="color:rgb(0,0,0);">进制方式发送的，不是 </font><font style="color:rgb(0,0,0);">ASCII </font><font style="color:rgb(0,0,0);">码。 </font>

<font style="color:rgb(0,0,0);">2</font><font style="color:rgb(0,0,0);">、 每个数据分低字节和高字节依次传送，二者组合成一个有符号的 </font><font style="color:rgb(0,0,0);">short</font><font style="color:rgb(0,0,0);">类型的数据。 </font>

<font style="color:rgb(0,0,0);">例如 </font><font style="color:rgb(0,0,0);">X </font><font style="color:rgb(0,0,0);">轴加速度数据 </font><font style="color:rgb(0,0,0);">Ax</font><font style="color:rgb(0,0,0);">，其中 </font><font style="color:rgb(0,0,0);">AxL </font><font style="color:rgb(0,0,0);">为低字节，</font><font style="color:rgb(0,0,0);">AxH </font><font style="color:rgb(0,0,0);">为高字节。转换方法如下： </font>

<font style="color:rgb(0,0,0);">假设 Data 为实际的数据，DataH 为其高字节部分，DataL 为其低字节部分， 那么： Data=((short)DataH<<8)|DataL。这里一定要注意 DataH 需要先强制转换为一个有符号的 short </font>

<font style="color:rgb(0,0,0);">类型的数据以后再移位，并且 </font><font style="color:rgb(0,0,0);">Data </font><font style="color:rgb(0,0,0);">的数据类型也是有符号的 </font><font style="color:rgb(0,0,0);">short </font><font style="color:rgb(0,0,0);">类型，这样才能表示出 </font>

<font style="color:rgb(0,0,0);">负数。</font>

# <font style="color:rgb(0,0,0);">单次回传寄存器的数据包</font>
<font style="color:rgb(0,0,0);">单次回传的数据包需要先发送读取寄存器指令，指令格式如下：</font>

## <font style="color:rgb(0,0,0);">1、上位机至主机</font>
| <font style="color:rgb(0,0,0);">FF  AA  27  XX  00</font> |
| :---: |

<font style="color:rgb(0,0,0);">--XX 指的是对应寄存器编号，寄存器的编号数值参考，发送指令示例如下：</font>

| <font style="color:rgb(0,0,0);">功能 </font> | <font style="color:rgb(0,0,0);">指令 </font> |
| --- | --- |
| <font style="color:rgb(0,0,0);">读 取 从 机 数 量</font> | <font style="color:rgb(0,0,0);">FF AA 27 05 00 </font> |

<font style="color:rgb(0,0,0);">发送此指令后，模块会回传一次 0x55 0x71 开头的数据包，内有对应开始寄存器地址 数据、开始寄存器地址开始以及后面 7 个寄存器数据(固定上传 8 个寄存器），回传数据格式如下：</font>

<font style="color:rgb(0,0,0);">开始寄存器（2Byte）+寄存器数据(16Byte,8 个寄存器)</font>

| <font style="color:rgb(0,0,0);">包头 </font><br/><font style="color:rgb(0,0,0);"></font><br/> | <font style="color:rgb(0,0,0);">标志 </font> | <font style="color:rgb(0,0,0);">开始寄存器地址低位 </font> | <font style="color:rgb(0,0,0);">开始寄存器地址高位</font> | <font style="color:rgb(0,0,0);">开始（第1个)寄存器数据低位 </font> | <font style="color:rgb(0,0,0);">开（第1个)寄存器数高位 </font> | ...... | <font style="color:rgb(0,0,0);">第8个寄存器数据低位</font> | <font style="color:rgb(0,0,0);">第8个寄存器数据高位</font> |
| --- | --- | --- | --- | --- | --- | --- | --- | --- |
| <font style="color:rgb(0,0,0);">0x55 </font> | <font style="color:rgb(0,0,0);">0x71 </font> | <font style="color:rgb(0,0,0);">RegL</font> | <font style="color:rgb(0,0,0);">RegH </font> | <font style="color:rgb(0,0,0);">0xNN </font> | <font style="color:rgb(0,0,0);">0xNN</font> | <font style="color:rgb(0,0,0);">...... </font> | <font style="color:rgb(0,0,0);">0xNN </font> | <font style="color:rgb(0,0,0);">0xNN</font> |

例如：55 71 05 00 06 00 00 00 00 00 00 00 00 00 00 00 00 00 00 00

得到当前可读取从机数量 6

<font style="color:rgb(0,0,0);">注：0xNN 是收到的具体数值，低字节在前，高字节在后。</font>

## <font style="color:rgb(0,0,0);">2、上位机至从机</font>
| <font style="color:rgb(0,0,0);">FF  BB  **  27  XX  00</font> |
| :---: |

--<font style="color:rgb(0,0,0);">**  指的是对应从机设备号，</font>

<font style="color:rgb(0,0,0);">--XX 指的是对应寄存器编号，寄存器的编号数值参考，发送指令示例如下：</font>

| <font style="color:rgb(0,0,0);">功能 </font> | <font style="color:rgb(0,0,0);">指令 </font> |
| --- | --- |
| <font style="color:rgb(0,0,0);">读 取 01 设 备 当 前 算 法</font> | <font style="color:rgb(0,0,0);">FF BB 01 27 24 00 </font> |
| <font style="color:rgb(0,0,0);">读 取 02 设 备 当 前 带 宽</font> | <font style="color:rgb(0,0,0);">FF BB 02 27 1f 00 </font> |
| <font style="color:rgb(0,0,0);">读 取 03 设 备  安 装 方 向 </font> | <font style="color:rgb(0,0,0);">FF BB 03 27 23 00 </font> |

<font style="color:rgb(0,0,0);">发送此指令后，模块会回传一次 0xNN 0x55 0x71 开头的数据包，内有对应开始寄存器地址 数据、开始寄存器地址开始以及后面 7 个寄存器数据(固定上传 8 个寄存器），回传数据格式如下：</font>

<font style="color:rgb(0,0,0);">开始寄存器（2Byte）+寄存器数据(16Byte,8 个寄存器)</font>

| 从机号 | <font style="color:rgb(0,0,0);">包头 </font><br/><font style="color:rgb(0,0,0);"></font><br/> | <font style="color:rgb(0,0,0);">标志 </font> | <font style="color:rgb(0,0,0);">开始寄存器地址低位 </font> | <font style="color:rgb(0,0,0);">开始寄存器地址高位</font> | <font style="color:rgb(0,0,0);">开始（第1个)寄存器数据低位 </font> | <font style="color:rgb(0,0,0);">开（第1个)寄存器数高位 </font> | <font style="color:rgb(0,0,0);">......</font> | <font style="color:rgb(0,0,0);">第8个寄存器数据低位</font> | <font style="color:rgb(0,0,0);">第8个寄存器数据高位</font> |
| --- | --- | --- | --- | --- | --- | --- | --- | --- | --- |
| 0xNN | <font style="color:rgb(0,0,0);">0x55 </font> | <font style="color:rgb(0,0,0);">0x71 </font> | <font style="color:rgb(0,0,0);">RegL</font> | <font style="color:rgb(0,0,0);">RegH </font> | <font style="color:rgb(0,0,0);">0xNN </font> | <font style="color:rgb(0,0,0);">0xNN</font> | <font style="color:rgb(0,0,0);">...... </font> | <font style="color:rgb(0,0,0);">0xNN </font> | <font style="color:rgb(0,0,0);">0xNN</font> |

<font style="color:rgb(0,0,0);">注：0xNN 是收到的具体数值，低字节在前，高字节在后。</font>

<font style="color:rgb(0,0,0);"></font>

# <font style="color:rgb(0,0,0);">上位机设置模块的指令</font>
<font style="color:rgb(0,0,0);">上位机设置模块的指令，指令格式如下：</font>

## <font style="color:rgb(0,0,0);">上位机至主机</font>
## 发送指令：
### 读取寄存器值
| FF AA 27 XX 00 | 读取寄存器值 |
| --- | --- |

<font style="color:rgb(0,0,0);">--XX 指的是对应寄存器。</font>

<font style="color:rgb(0,0,0);">发送此指令后，模块会回传一次 0x55 0x71 开头的数据包，内有对应开始寄存器地址 数据、开始寄存器地址开始以及后面 7 个寄存器数据(固定上传 8 个寄存器）</font>

### <font style="color:rgb(0,0,0);">设置从机数量</font>
| <font style="color:rgb(0,0,0);">FF AA 05 XX 00 </font> | <font style="color:rgb(0,0,0);">设置从机数量</font> |
| --- | --- |

<font style="color:rgb(0,0,0);">--XX 指的是设置的从机数量，可设置0x06~0x20。</font>

### 保存配置
| <font style="color:rgb(0,0,0);">FF AA 00 SAVE 00 </font> | <font style="color:rgb(0,0,0);">保存配置</font> |
| --- | --- |

<font style="color:rgb(0,0,0);">SAVE</font><font style="color:rgb(0,0,0);">：设置 </font>

<font style="color:rgb(0,0,0);">0</font><font style="color:rgb(0,0,0);">：保存当前配置 </font>

<font style="color:rgb(0,0,0);">1：恢复默认配置并保存</font>

<font style="color:rgb(0,0,0);"></font>

### <font style="color:rgb(0,0,0);">版本号输出</font>
| <font style="color:rgb(0,0,0);">0x55 </font> | <font style="color:rgb(0,0,0);">0x71 </font> | <font style="color:rgb(0,0,0);">0x2E</font> | <font style="color:rgb(0,0,0);">0x00 </font> | <font style="color:rgb(0,0,0);">Version1L</font> | <font style="color:rgb(0,0,0);">Version1H</font> | <font style="color:rgb(0,0,0);">......</font> |
| --- | --- | --- | --- | --- | --- | --- |
| <font style="color:rgb(0,0,0);">0x55 </font> | <font style="color:rgb(0,0,0);">0x71 </font> | <font style="color:rgb(0,0,0);">0x2F</font> | <font style="color:rgb(0,0,0);">0x00 </font> | <font style="color:rgb(0,0,0);">Version2L</font> | <font style="color:rgb(0,0,0);">Version2H</font> | <font style="color:rgb(0,0,0);">......</font> |

<font style="color:rgb(0,0,0);">版本号计算公式： </font>

<font style="color:rgb(0,0,0);">Version1=((Version1H<<8)|VersionL1) </font>

<font style="color:rgb(0,0,0);">VERSION=Version1.Version2H.Version2L  </font>

## <font style="color:rgb(0,0,0);">上位机至从机</font>
## 发送指令：
### 读取寄存器值
| FF BB ** 27 XX 00 | 读取寄存器值 |
| --- | --- |

--<font style="color:rgb(0,0,0);">**  指的是对应从机设备号，</font>

<font style="color:rgb(0,0,0);">--XX 指的是对应寄存器。</font>

<font style="color:rgb(0,0,0);">发送此指令后，模块会回传一次 0xNN 0x55 0x71 开头的数据包，内有对应开始寄存器地址 数据、开始寄存器地址开始以及后面 7 个寄存器数据(固定上传 8 个寄存器）</font>

<font style="color:rgb(0,0,0);"></font>

### <font style="color:rgb(0,0,0);">修改从机ID</font>
| <font style="color:rgb(0,0,0);">FF BB ** 1A XX 00 </font> | <font style="color:rgb(0,0,0);">修改从机ID</font> |
| --- | --- |

<font style="color:rgb(0,0,0);">--**  指的是当前的从机ID，</font>

<font style="color:rgb(0,0,0);">--XX 指的是设置的从机ID，可设置0x00~0x20。</font>

<font style="color:rgb(0,0,0);"></font>

### <font style="color:rgb(0,0,0);">版本号输出</font>
| 0xNN | <font style="color:rgb(0,0,0);">0x55 </font> | <font style="color:rgb(0,0,0);">0x71 </font> | <font style="color:rgb(0,0,0);">0x2E</font> | <font style="color:rgb(0,0,0);">0x00 </font> | <font style="color:rgb(0,0,0);">Version1L</font> | <font style="color:rgb(0,0,0);">Version1H</font> | <font style="color:rgb(0,0,0);">......</font> |
| --- | --- | --- | --- | --- | --- | --- | --- |
| 0xNN | <font style="color:rgb(0,0,0);">0x55 </font> | <font style="color:rgb(0,0,0);">0x71 </font> | <font style="color:rgb(0,0,0);">0x2F</font> | <font style="color:rgb(0,0,0);">0x00 </font> | <font style="color:rgb(0,0,0);">Version2L</font> | <font style="color:rgb(0,0,0);">Version2H</font> | <font style="color:rgb(0,0,0);">......</font> |

<font style="color:rgb(0,0,0);">版本号计算公式： </font>

<font style="color:rgb(0,0,0);">Version1=((Version1H<<8)|VersionL1) </font>

<font style="color:rgb(0,0,0);">VERSION=Version1.Version2H.Version2L  </font>

<font style="color:rgb(0,0,0);"></font>

### <font style="color:rgb(0,0,0);">加速度校准</font>
| <font style="color:rgb(0,0,0);">FF BB ** 01 01 00 </font> | <font style="color:rgb(0,0,0);">加速度计校准 </font> |
| --- | --- |

### 保存配置
| <font style="color:rgb(0,0,0);">FF BB ** 00 SAVE 00 </font> | <font style="color:rgb(0,0,0);">保存配置</font> |
| --- | --- |

<font style="color:rgb(0,0,0);">SAVE</font><font style="color:rgb(0,0,0);">：设置 </font>

<font style="color:rgb(0,0,0);">0</font><font style="color:rgb(0,0,0);">：保存当前配置 </font>

<font style="color:rgb(0,0,0);">1：恢复默认配置并保存</font>

<font style="color:rgb(0,0,0);"></font>

### <font style="color:rgb(0,0,0);">设置角度参考</font>
| <font style="color:rgb(0,0,0);">FF BB ** 01 08 00 </font> | <font style="color:rgb(0,0,0);">设置角度参考</font> |
| --- | --- |

发送后，需要发送保存指令

### <font style="color:rgb(0,0,0);">设置Z轴角度归零</font>
| <font style="color:rgb(0,0,0);">FF BB ** 01 04 00 </font> | <font style="color:rgb(0,0,0);">设置z轴角度归零</font> |
| --- | --- |

发送这个指令前需要先切换六轴算法，才可以生效。

<font style="color:rgb(0,0,0);"></font>

### <font style="color:rgb(0,0,0);">修改安装方向</font>
| <font style="color:rgb(0,0,0);">FF BB ** 23 XX 00 </font> | <font style="color:rgb(0,0,0);">修改从机安装方向</font> |
| --- | --- |

<font style="color:rgb(0,0,0);">--**  指的是当前的从机ID，</font>

<font style="color:rgb(0,0,0);">--XX 指的是设置的从机安装方向，</font>

<font style="color:rgb(24, 24, 24);">0(0x00)</font>: <font style="color:rgb(24, 24, 24);">水平安装</font>

<font style="color:rgb(24, 24, 24);">1(0x01)</font>: <font style="color:rgb(24, 24, 24);">垂直安装（必须TypeC口朝下）</font>

<font style="color:rgb(0,0,0);"></font>

### <font style="color:rgb(0,0,0);">修改从机带宽</font>
| <font style="color:rgb(0,0,0);">FF BB ** 1f XX XX</font> | <font style="color:rgb(0,0,0);">修改从机带宽</font> |
| --- | --- |

<font style="color:rgb(0,0,0);">--**  指的是当前的从机ID，</font>

<font style="color:rgb(0,0,0);">--XX XX 指的是设置的从机带宽，如下所示。</font>

| 寄存器名称: <font style="color:rgb(0,0,0);">BANDWIDTH</font><br/>寄存器地址: 31 (0x1F)<br/>读写方向: R/W<br/>默认值: 0x0004  | | |
| :--- | --- | --- |
| Bit |  NAME |  FUNCTION |
| <font style="color:rgb(0,0,0);">15:4</font> |  |  |
| <font style="color:rgb(0,0,0);">3:0</font> | <font style="color:rgb(0,0,0);">BANDWIDTH[3:0]</font> | <font style="color:rgb(24, 24, 24);">设置带宽</font><br/><font style="color:rgb(24, 24, 24);">0000(0x00)</font>: <font style="color:rgb(24, 24, 24);">256Hz</font><br/><font style="color:rgb(24, 24, 24);">0001(0x01)</font>: <font style="color:rgb(24, 24, 24);">188Hz</font><br/><font style="color:rgb(24, 24, 24);">0010(0x02)</font>: <font style="color:rgb(24, 24, 24);">98Hz</font><br/><font style="color:rgb(24, 24, 24);">0011(0x03)</font>: <font style="color:rgb(24, 24, 24);">42Hz</font><br/><font style="color:rgb(24, 24, 24);">0100(0x04)</font>: <font style="color:rgb(24, 24, 24);">20Hz</font><br/><font style="color:rgb(24, 24, 24);">0101(0x05)</font>: <font style="color:rgb(24, 24, 24);">10Hz</font><br/><font style="color:rgb(24, 24, 24);">0110(0x06)</font>: <font style="color:rgb(24, 24, 24);">5Hz</font> |
| 示例：FF <font style="color:rgb(0,0,0);">BB **</font> 1F 01 00（设置带宽为188Hz） | | |

<font style="color:rgb(0,0,0);"></font>

### <font style="color:rgb(0,0,0);">修改从机算法</font>
| <font style="color:rgb(0,0,0);">FF BB ** 24 XX 00 </font> | <font style="color:rgb(0,0,0);">修改从机算法</font> |
| --- | --- |

<font style="color:rgb(0,0,0);">--**  指的是当前的从机ID，</font>

<font style="color:rgb(0,0,0);">--XX 指的是设置的从机算法，如下所示。</font>

| <font style="color:rgb(24, 24, 24);">AXIS6</font> | <font style="color:rgb(24, 24, 24);">设置算法</font><br/><font style="color:rgb(24, 24, 24);">0(0x00)：9轴算法（磁场解算航行角，绝对航向角）</font><br/><font style="color:rgb(24, 24, 24);">1(0x01)：6轴算法（积分解算航行角，相对航向角）</font> |
| --- | --- |

<font style="color:rgb(0,0,0);"></font>

## <font style="color:rgb(0,0,0);">寄存器地址表</font>
| <font style="color:rgb(0,0,0);">地址 </font> | <font style="color:rgb(0,0,0);">符号 </font> | <font style="color:rgb(0,0,0);">含义 </font> |
| --- | --- | --- |
| <font style="color:rgb(0,0,0);">0x00 </font> | <font style="color:rgb(0,0,0);">SAVE</font> | <font style="color:rgb(0,0,0);">保存当前配置 </font> |
| <font style="color:rgb(0,0,0);">0x01 </font> | <font style="color:rgb(0,0,0);">CALSW </font> | <font style="color:rgb(0,0,0);">校准</font> |
| <font style="color:rgb(0,0,0);">0x02 </font> | <font style="color:rgb(0,0,0);">保留 </font> | |
| <font style="color:rgb(0,0,0);">0x03 </font> | <font style="color:rgb(0,0,0);">RATE </font> | <font style="color:rgb(0,0,0);">回传数据速率</font> |
| <font style="color:rgb(0,0,0);">0x04 </font> | <font style="color:rgb(0,0,0);">BAUD </font> | <font style="color:rgb(0,0,0);">串口波特率 </font> |
| <font style="color:rgb(0,0,0);">0x05 </font> | <font style="color:rgb(0,0,0);">AXOFFSET </font> | <font style="color:rgb(0,0,0);">X 轴加速度零偏</font> |
| <font style="color:rgb(0,0,0);">0x06 </font> | <font style="color:rgb(0,0,0);">AYOFFSET</font> | <font style="color:rgb(0,0,0);">Y 轴加速度零偏 </font> |
| <font style="color:rgb(0,0,0);">0x07</font> | <font style="color:rgb(0,0,0);">AZOFFSET</font> | <font style="color:rgb(0,0,0);">Z 轴加速度零偏 </font> |
| <font style="color:rgb(0,0,0);">0x08 </font> | <font style="color:rgb(0,0,0);">GXOFFSET</font> | <font style="color:rgb(0,0,0);">X 轴角速度零偏</font> |

| <font style="color:rgb(0,0,0);">0x09 </font> | <font style="color:rgb(0,0,0);">GYOFFSET </font> | <font style="color:rgb(0,0,0);">Y 轴角速度零偏</font> |
| --- | --- | --- |
| <font style="color:rgb(0,0,0);">0x0a </font> | <font style="color:rgb(0,0,0);">GZOFFSET </font> | <font style="color:rgb(0,0,0);">Z 轴角速度零偏 </font> |
| <font style="color:rgb(0,0,0);">0x0b</font> | <font style="color:rgb(0,0,0);">HXOFFSET</font> | <font style="color:rgb(0,0,0);">X 轴磁场零偏</font> |
| <font style="color:rgb(0,0,0);">0x0c</font> | <font style="color:rgb(0,0,0);">HYOFFSET</font> | <font style="color:rgb(0,0,0);">Y 轴磁场零偏 </font> |
| <font style="color:rgb(0,0,0);">0x0d</font> | <font style="color:rgb(0,0,0);">HZOFFSET</font> | <font style="color:rgb(0,0,0);">Z 轴磁场零偏 </font> |
| <font style="color:rgb(0,0,0);">0x0e</font> | <font style="color:rgb(0,0,0);">D0MODE</font> | <font style="color:rgb(0,0,0);">D0 模式</font> |
| <font style="color:rgb(0,0,0);">0x0f</font> | <font style="color:rgb(0,0,0);">D1MODE </font> | <font style="color:rgb(0,0,0);">D1 模式 </font> |
| <font style="color:rgb(0,0,0);">0x10</font> | <font style="color:rgb(0,0,0);">D2MODE</font> | <font style="color:rgb(0,0,0);">D2 模式 </font> |
| <font style="color:rgb(0,0,0);">0x11 </font> | <font style="color:rgb(0,0,0);">D3MODE</font> | <font style="color:rgb(0,0,0);">D3 模式 </font> |
| <font style="color:rgb(0,0,0);">0x12 </font> | <font style="color:rgb(0,0,0);">保留 </font> | |

| <font style="color:rgb(0,0,0);">0x13 </font> | <font style="color:rgb(0,0,0);">保留</font> | |
| --- | --- | --- |
| <font style="color:rgb(0,0,0);">0x14</font> | <font style="color:rgb(0,0,0);">保留 </font> | |
| <font style="color:rgb(0,0,0);">0x15</font> | <font style="color:rgb(0,0,0);">保留 </font> | |
| <font style="color:rgb(0,0,0);">0x16</font> | <font style="color:rgb(0,0,0);">保留 </font> | |
| <font style="color:rgb(0,0,0);">0x17</font> | <font style="color:rgb(0,0,0);">保留 </font> | |
| <font style="color:rgb(0,0,0);">0x18</font> | <font style="color:rgb(0,0,0);">保留 </font> | |
| <font style="color:rgb(0,0,0);">0x19</font> | <font style="color:rgb(0,0,0);">保留 </font> | |
| <font style="color:rgb(0,0,0);">0x1a</font> | <font style="color:rgb(0,0,0);">保留 </font> | |
| <font style="color:rgb(0,0,0);">0x1b </font> | <font style="color:rgb(0,0,0);">保留 </font> | |
| <font style="color:rgb(0,0,0);">......</font> | <font style="color:rgb(0,0,0);">...... </font> | <font style="color:rgb(0,0,0);">...... </font> |

| <font style="color:rgb(0,0,0);">0x30 </font> | <font style="color:rgb(0,0,0);">YYMM</font> | <font style="color:rgb(0,0,0);">年、月 </font> |
| --- | --- | --- |
| <font style="color:rgb(0,0,0);">0x31 </font> | <font style="color:rgb(0,0,0);">DDHH </font> | 日、时 |
| <font style="color:rgb(0,0,0);">0x32</font> | <font style="color:rgb(0,0,0);">MMSS </font> | <font style="color:rgb(0,0,0);">分、秒 </font> |
| <font style="color:rgb(0,0,0);">0x33</font> | <font style="color:rgb(0,0,0);">MS</font> | <font style="color:rgb(0,0,0);">毫秒</font> |
| <font style="color:rgb(0,0,0);">0x34</font> | <font style="color:rgb(0,0,0);">AX</font> | <font style="color:rgb(0,0,0);">X 轴加速度</font> |
| <font style="color:rgb(0,0,0);">0x35</font> | <font style="color:rgb(0,0,0);">AY </font> | <font style="color:rgb(0,0,0);">Y 轴加速度</font> |
| <font style="color:rgb(0,0,0);">0x36 </font> | <font style="color:rgb(0,0,0);">AZ </font> | <font style="color:rgb(0,0,0);">Z 轴加速度 </font> |
| <font style="color:rgb(0,0,0);">0x37 </font> | <font style="color:rgb(0,0,0);">GX</font> | <font style="color:rgb(0,0,0);">X 轴角速度</font> |
| <font style="color:rgb(0,0,0);">0x38</font> | <font style="color:rgb(0,0,0);">GY </font> | <font style="color:rgb(0,0,0);">Y 轴角速度</font> |
| <font style="color:rgb(0,0,0);">0x39</font> | <font style="color:rgb(0,0,0);">GZ</font> | <font style="color:rgb(0,0,0);">Z 轴角速度</font> |

| <font style="color:rgb(0,0,0);">0x3a</font> | <font style="color:rgb(0,0,0);">HX </font> | <font style="color:rgb(0,0,0);">X 轴磁场 </font> |
| --- | --- | --- |
| <font style="color:rgb(0,0,0);">0x3b</font> | <font style="color:rgb(0,0,0);">HY</font> | <font style="color:rgb(0,0,0);">Y 轴磁场 </font> |
| <font style="color:rgb(0,0,0);">0x3c</font> | <font style="color:rgb(0,0,0);">HZ </font> | <font style="color:rgb(0,0,0);">Z 轴磁场 </font> |
| <font style="color:rgb(0,0,0);">0x3d</font> | <font style="color:rgb(0,0,0);">Roll</font> | <font style="color:rgb(0,0,0);">X 轴角度 </font> |
| <font style="color:rgb(0,0,0);">0x3e</font> | <font style="color:rgb(0,0,0);">Pitch</font> | <font style="color:rgb(0,0,0);">Y 轴角度 </font> |
| <font style="color:rgb(0,0,0);">0x3f </font> | <font style="color:rgb(0,0,0);">Yaw</font> | <font style="color:rgb(0,0,0);">Z 轴角度 </font> |
| <font style="color:rgb(0,0,0);">0x40</font> | <font style="color:rgb(0,0,0);">TEMP </font> | <font style="color:rgb(0,0,0);">模块温度</font> |
| <font style="color:rgb(0,0,0);">0x49</font> | <font style="color:rgb(0,0,0);">保留 </font> | |
| <font style="color:rgb(0,0,0);">0x4a</font> | <font style="color:rgb(0,0,0);">保留</font> | |
| <font style="color:rgb(0,0,0);">0x4b </font> | <font style="color:rgb(0,0,0);">保留 </font> | |

| <font style="color:rgb(0,0,0);">0x4c </font> | <font style="color:rgb(0,0,0);">保留</font> | |
| --- | --- | --- |
| <font style="color:rgb(0,0,0);">0x4d</font> | <font style="color:rgb(0,0,0);">保留 </font> | |
| <font style="color:rgb(0,0,0);">0x4e</font> | <font style="color:rgb(0,0,0);">保留 </font> | |
| <font style="color:rgb(0,0,0);">0x4f</font> | <font style="color:rgb(0,0,0);">保留 </font> | |
| <font style="color:rgb(0,0,0);">0x50</font> | <font style="color:rgb(0,0,0);">保留 </font> | |
| <font style="color:rgb(0,0,0);">0x51</font> | <font style="color:rgb(0,0,0);">Q0</font> | <font style="color:rgb(0,0,0);">四元素 Q0 </font> |
| <font style="color:rgb(0,0,0);">0x52</font> | <font style="color:rgb(0,0,0);">Q1</font> | <font style="color:rgb(0,0,0);">四元素 Q1 </font> |
| <font style="color:rgb(0,0,0);">0x53</font> | <font style="color:rgb(0,0,0);">Q2 </font> | <font style="color:rgb(0,0,0);">四元素 Q2</font> |
| <font style="color:rgb(0,0,0);">0x54 </font> | <font style="color:rgb(0,0,0);">Q3</font> | <font style="color:rgb(0,0,0);">四元素 Q3</font> |
