junfoot/STM32F407_Muscle/Ref_project/STM32F407VET6_ADS1292/STM32_F4VX_M原理图.PDF

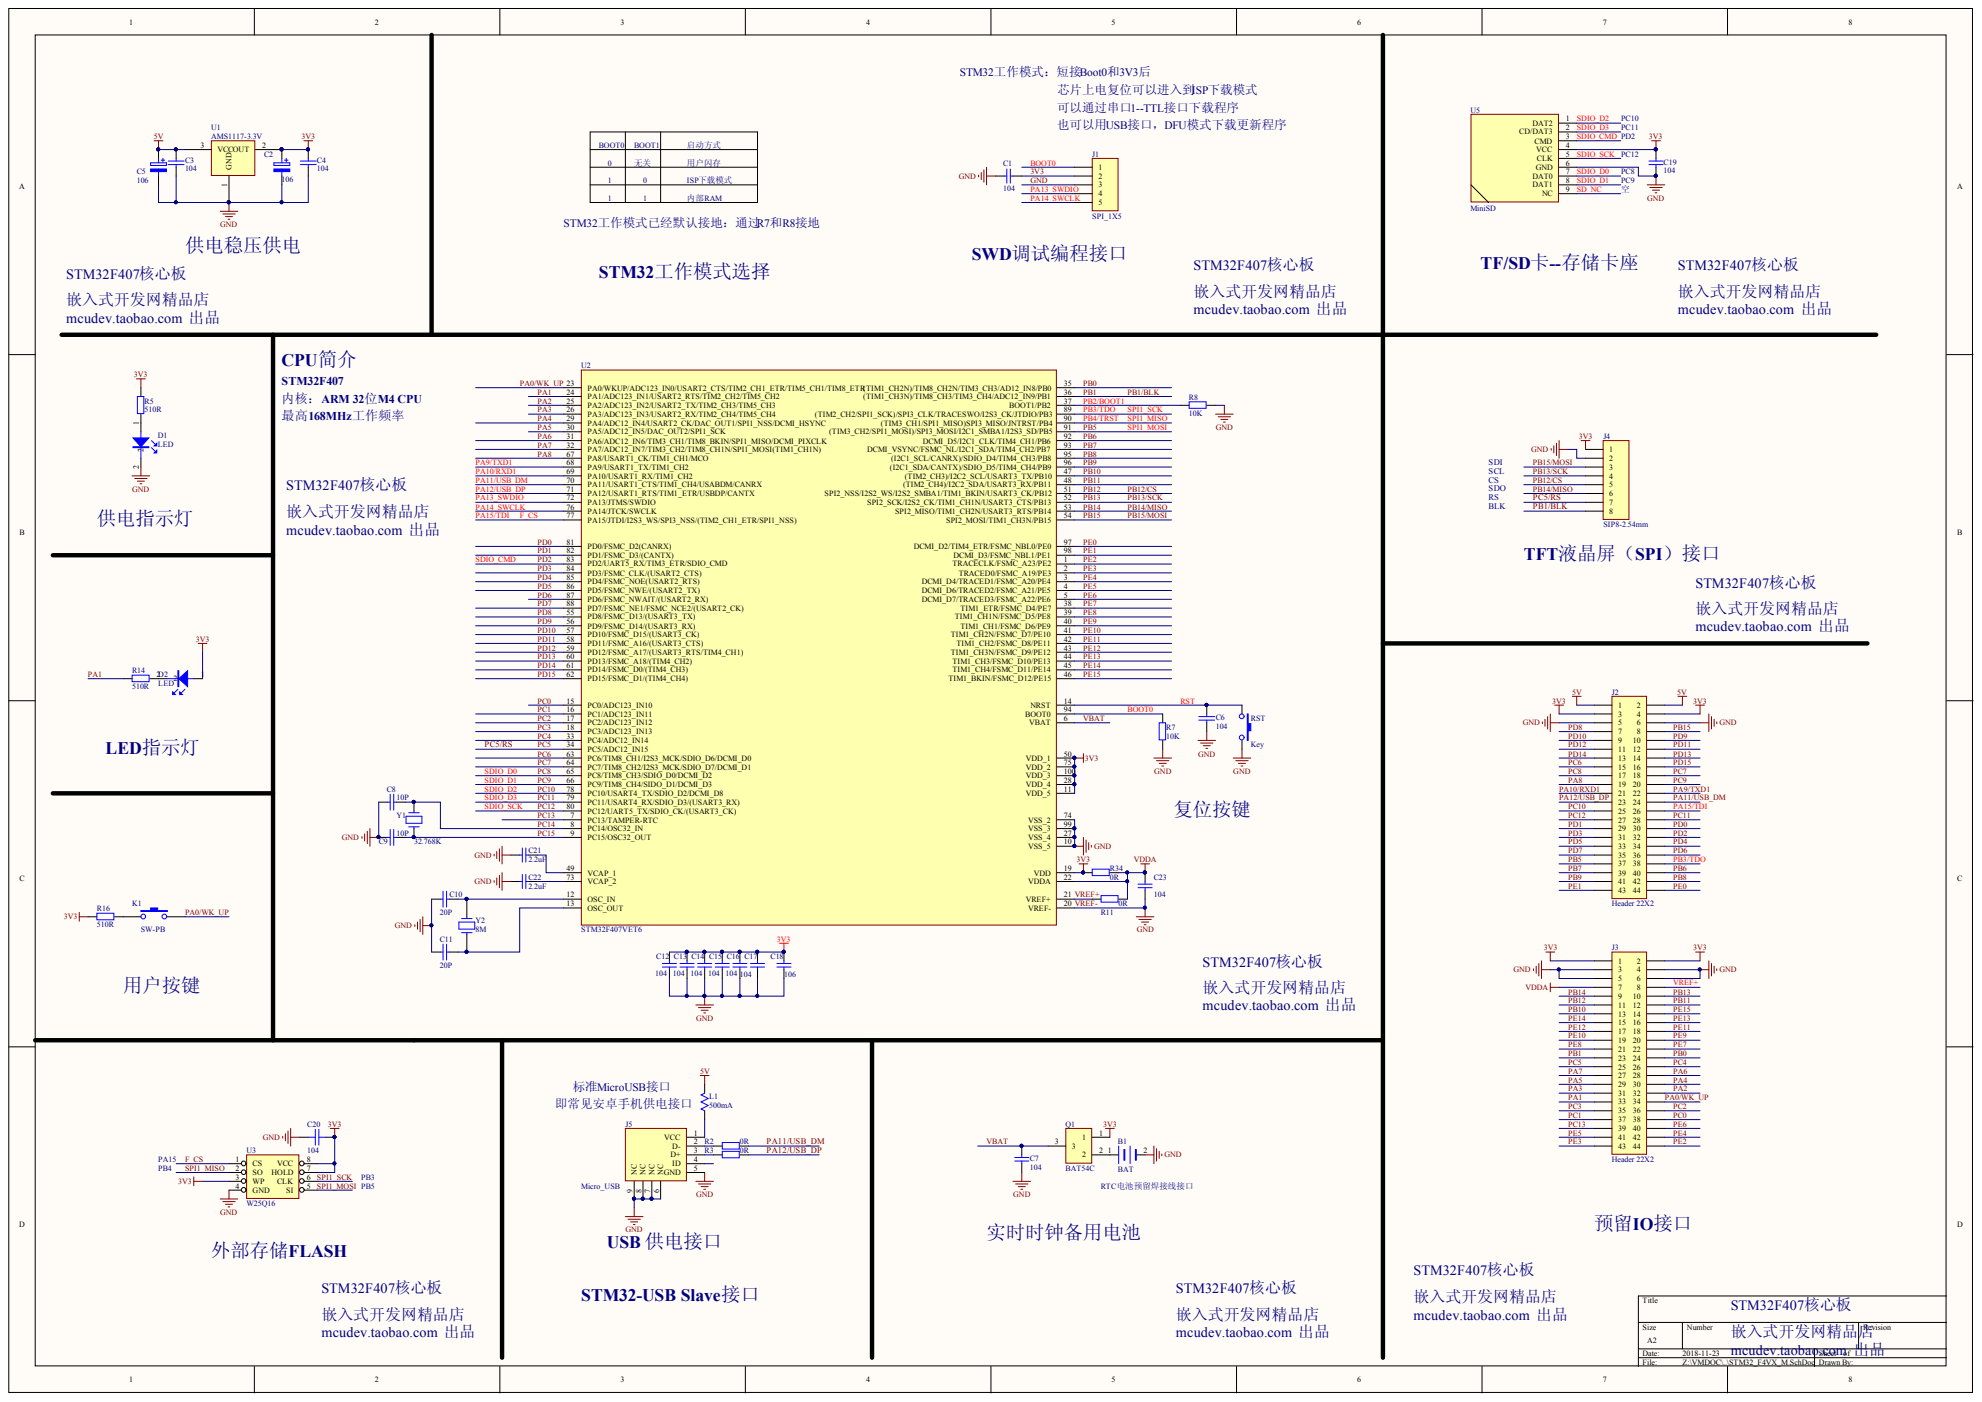
[picture p3: page 1]

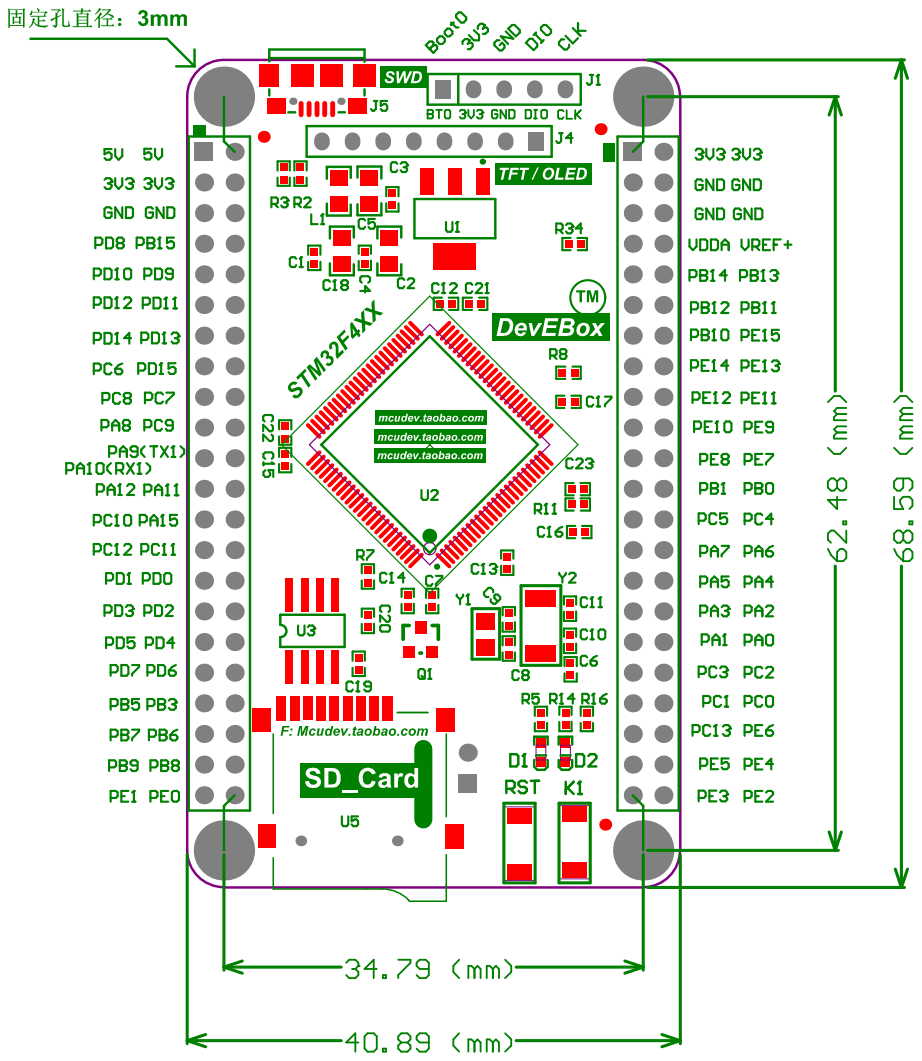
[picture p4: page 2]
