junfoot/STM32F407_Muscle/Core/Src/main.c

/* USER CODE BEGIN Header */
/**
  ******************************************************************************
  * @file           : main.c
  * @brief          : Main program body
  *
  *  - TIM3 @ 2000 Hz starts a synchronous conversion on both AD7606 chips;
  *    the BUSY falling edge (EXTI0) reads all 16 channels right in the ISR
  *    and pushes the raw frame into the SD recorder ring, so samples are
  *    captured completely even while a FatFs write blocks the main loop.
  *  - 100 Hz of the stream goes to USART1 as a VOFA+ JustFloat frame,
  *    59 little-endian float32 followed by the tail 00 00 80 7F:
  *      [0]    status: bit0 = SD card present, bit1 = USB device connected
  *             (0..3, updated live, hot-plug aware)
  *      [1..2] DAC A / DAC B output voltage (last commanded value)
  *      [3..18] 16 x raw ADC volts
  *      [19..34] 16 x filtered sEMG volts (20 Hz HP, 50 Hz notch, 450 Hz LP)
  *      [35..58] 4 IMU x [roll,pitch,yaw,ax,ay,az] (held between updates)
  *  - Every ADC sample and every raw IMU frame is also logged to the SD
  *    card (recorder.c, LOGxxxx.BIN) with a common 2000 Hz sequence number.
  *  - IMU data comes from the WT9011DCL-RF receiver attached to USB OTG FS
  *    (USB Host CDC, CH340 @ 460800), parsed by imu_parser.
  *  - USART1 RX takes line-based string commands (see cmd.h), e.g.
  *    "DAC A 3.3" sets DAC channel A to +3.3 V, "REC STOP" stops logging.
  *  - On-board button K3 (PA15, to GND) toggles SD recording start/stop;
  *    the PA1 LED (active low) is on while recording. See 原理图V2.8.
  *  - printf() is retargeted to USART1 through a non-blocking DMA ring
  *    buffer (serial.c), so logging never stalls the 2000 Hz loop.
  *
  *  Interrupt priorities: TIM3 (conversion start) = 0, EXTI0 (BUSY) = 1,
  *  USART1 = 2, DMA2 Stream7 (USART1 TX) = 3, OTG_FS (USB host) = 5.
  *  SDIO runs in polling mode (no IRQ).
  ******************************************************************************
  * @attention
  *
  * Copyright (c) 2026 STMicroelectronics.
  * All rights reserved.
  *
  * This software is licensed under terms that can be found in the LICENSE file
  * in the root directory of this software component.
  * If no LICENSE file comes with this software, it is provided AS-IS.
  *
  ******************************************************************************
  */
/* USER CODE END Header */
/* Includes ------------------------------------------------------------------*/
#include "main.h"
#include "dma.h"
#include "tim.h"
#include "usart.h"
#include "sdio.h"
#include "usb_host.h"
#include "gpio.h"

/* USER CODE BEGIN Includes */
#include "ad7606.h"
#include "emg_filter.h"
#include "dac8563.h"
#include "serial.h"
#include "cmd.h"
#include "imu_parser.h"
#include "recorder.h"
#include "usbh_cdc.h"

#include <stdio.h>
#include <string.h>
/* USER CODE END Includes */

/* USER CODE BEGIN PTD */
typedef enum
{
  CDC_STATE_IDLE = 0,
  CDC_STATE_SET_LINE_CODING,
  CDC_STATE_SET_CONTROL_LINE,
  CDC_STATE_START_RECEPTION,
  CDC_STATE_RUNNING
} CDC_AppStateTypeDef;
/* USER CODE END PTD */

/* USER CODE BEGIN PD */
#define IMU_COUNT                    4u      /* slaves with device_id 0..3        */
#define IMU_FLOATS_PER_UNIT          6u      /* roll,pitch,yaw + ax,ay,az         */
#define TX_META_FLOATS               3u      /* status + DAC A + DAC B (first)    */
#define TX_CH_COUNT                  (TX_META_FLOATS + (2u * AD7606_TOTAL_CH) + IMU_COUNT * IMU_FLOATS_PER_UNIT)
#define TX_FRAME_LEN                 (TX_CH_COUNT * 4u + 4u)   /* floats + tail  */
#define TX_DECIMATION                20u     /* 2000 Hz / 20 = 100 Hz on UART  */
#define ADC_LSB_VOLTS                (5.0f / 32768.0f)         /* +/-5 V range   */

#define CDC_RX_BUF_SIZE              512U
#define CDC_RX_TIMEOUT_MS            2000U
#define CDC_REQ_SET_CONTROL_LINE_STATE 0x22U
#define CDC_CTRL_LINE_DTR_RTS        0x0003U
#define CDC_LINE_CODING_TIMEOUT_MS   2000U
#define CDC_BAUDRATE                 460800U
/* USER CODE END PD */


/* USER CODE BEGIN PV */
extern ApplicationTypeDef Appli_state;
extern USBH_HandleTypeDef hUsbHostFS;

volatile uint32_t g_sample_seq = 0u;        /* 2000 Hz tick, shared with recorder */
static volatile uint8_t g_new_sample = 0u;  /* set by EXTI ISR after ADC read   */
static int16_t  g_adc_values[AD7606_TOTAL_CH];
static volatile float g_emg_filtered_volts[AD7606_TOTAL_CH];
static float    g_tx_fdata[TX_CH_COUNT];
static uint8_t  g_tx_frame[TX_FRAME_LEN];
static const uint8_t g_tx_tail[4] = {0x00u, 0x00u, 0x80u, 0x7Fu};  /* JustFloat tail */
static uint32_t g_next_uart_seq = 0u;

static uint8_t cdc_rx_buf[CDC_RX_BUF_SIZE];
static CDC_LineCodingTypeDef cdc_linecoding;
static volatile CDC_AppStateTypeDef cdc_state = CDC_STATE_IDLE;
static volatile uint8_t  cdc_line_coding_done = 0;
static volatile uint8_t  cdc_rx_ready = 0;
static volatile uint32_t cdc_last_rx_tick = 0;
static uint32_t cdc_line_coding_start_tick = 0;
/* USER CODE END PV */

void SystemClock_Config(void);
/* USER CODE BEGIN PFP */
static void CDC_Process(void);
static USBH_StatusTypeDef CDC_SetControlLineState(USBH_HandleTypeDef *phost, uint16_t state);
static void build_sample_frame(void);
static void rec_switch_poll(void);
/* USER CODE END PFP */

/**
  * @brief  The application entry point.
  * @retval int
  */
int main(void)
{

  /* MCU Configuration--------------------------------------------------------*/

  /* Reset of all peripherals, Initializes the Flash interface and the Systick. */
  HAL_Init();

  /* Configure the system clock */
  SystemClock_Config();

  /* Initialize all configured peripherals */
  MX_GPIO_Init();
  MX_DMA_Init();
  MX_TIM3_Init();
  MX_USART1_UART_Init();
  MX_SDIO_SD_Init();
  MX_USB_HOST_Init();
  /* USER CODE BEGIN 2 */
  AD7606_Init();
  EMG_Filter_Init();
  DAC8563_Init();

  /* Boot-time status, printed once at reset (the JustFloat stream keeps
     reporting both live in channel 0). Recorder_Init only probes the card;
     it does not create a file or start recording. USB detection gets a
     bounded 2 s enumeration window; TIM3 sampling is not started yet. */
  uint8_t boot_sd = Recorder_Init();
  uint8_t boot_usb = 0u;
  uint32_t usb_wait = HAL_GetTick();
  while ((HAL_GetTick() - usb_wait) < 2000u)
  {
    MX_USB_HOST_Process();
    if (Appli_state == APPLICATION_READY)
    {
      boot_usb = 1u;
      break;
    }
  }
  if ((Appli_state == APPLICATION_START) || (Appli_state == APPLICATION_READY))
  {
    boot_usb = 1u;
  }

  printf("\r\n[BOOT] SD=%u USB=%u (1=present)\r\n", (unsigned int)boot_sd, (unsigned int)boot_usb);
  printf("STM32F407_Muscle ready. USART1 @ 921600 8N1, JustFloat %u ch @ 100 Hz\r\n",
         (unsigned int)TX_CH_COUNT);
  printf("ch0: connection status (bit0=SD present, bit1=USB connected), ch1-2: DAC A/B volts\r\n");
  printf("Type HELP for commands.\r\n");

  Cmd_Init();
  HAL_TIM_Base_Start_IT(&htim3);
  /* USER CODE END 2 */

  /* Infinite loop */
  /* USER CODE BEGIN WHILE */
  while (1)
  {
    MX_USB_HOST_Process();
    CDC_Process();
    Recorder_Process();

    if ((g_new_sample != 0u) && ((int32_t)(g_sample_seq - g_next_uart_seq) >= 0))
    {
      g_new_sample = 0u;
      g_next_uart_seq = g_sample_seq + TX_DECIMATION;

      build_sample_frame();
      (void)Serial_Write(g_tx_frame, TX_FRAME_LEN);
    }

    Cmd_Process();

    rec_switch_poll();
    HAL_GPIO_WritePin(REC_LED_GPIO_Port, REC_LED_Pin,
                      (Recorder_IsActive() != 0u) ? GPIO_PIN_RESET : GPIO_PIN_SET);
    /* USER CODE END WHILE */

    /* USER CODE BEGIN 3 */
  }
  /* USER CODE END 3 */
}

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
/* USER CODE BEGIN 4 */
/**
  * @brief  Fill g_tx_frame with one JustFloat frame: 16 raw ADC channels in
  *         volts, followed by 16 filtered sEMG channels in volts, then for
  *         each IMU (id 0..3) roll/pitch/yaw in degrees and ax/ay/az in g.
  *         IMU fields hold their last value between updates.
  */
static void build_sample_frame(void)
{
  uint32_t idx = 0u;

  /* meta channels first: combined SD/USB status, then both DAC outputs */
  g_tx_fdata[idx++] = (float)((((Appli_state == APPLICATION_START) ||
                               (Appli_state == APPLICATION_READY)) ? 2u : 0u) |
                              ((Recorder_IsCardPresent() != 0u) ? 1u : 0u));
  g_tx_fdata[idx++] = DAC8563_GetVoltage(DAC8563_CH_A);
  g_tx_fdata[idx++] = DAC8563_GetVoltage(DAC8563_CH_B);

  /* latest ADC sample is written by the EXTI ISR; copy it atomically */
  __disable_irq();
  for (uint32_t i = 0u; i < AD7606_TOTAL_CH; i++)
  {
    g_tx_fdata[idx++] = (float)g_adc_values[i] * ADC_LSB_VOLTS;
  }
  for (uint32_t i = 0u; i < AD7606_TOTAL_CH; i++)
  {
    g_tx_fdata[idx++] = g_emg_filtered_volts[i];
  }
  __enable_irq();

  for (uint32_t id = 0u; id < IMU_COUNT; id++)
  {
    IMU_Data_t *d = IMU_GetSlaveData((uint8_t)id);

    /* guard against the parser updating the record from the OTG_FS ISR */
    __disable_irq();
    g_tx_fdata[idx++] = d->angle_deg[0];
    g_tx_fdata[idx++] = d->angle_deg[1];
    g_tx_fdata[idx++] = d->angle_deg[2];
    g_tx_fdata[idx++] = d->accel_g[0];
    g_tx_fdata[idx++] = d->accel_g[1];
    g_tx_fdata[idx++] = d->accel_g[2];
    __enable_irq();
  }

  memcpy(g_tx_frame, g_tx_fdata, TX_CH_COUNT * 4u);
  memcpy(&g_tx_frame[TX_CH_COUNT * 4u], g_tx_tail, 4u);
}

/**
  * @brief  Advance the USB CDC state machine (CH340 of the 9011RF receiver).
  */
static void CDC_Process(void)
{
  if (Appli_state == APPLICATION_READY)
  {
    switch (cdc_state)
    {
      case CDC_STATE_IDLE:
        cdc_linecoding.b.dwDTERate = CDC_BAUDRATE;
        cdc_linecoding.b.bCharFormat = 0U;
        cdc_linecoding.b.bParityType = 0U;
        cdc_linecoding.b.bDataBits = 8U;
        cdc_line_coding_done = 0U;
        cdc_line_coding_start_tick = HAL_GetTick();
        USBH_CDC_SetLineCoding(&hUsbHostFS, &cdc_linecoding);
        cdc_state = CDC_STATE_SET_LINE_CODING;
        break;

      case CDC_STATE_SET_LINE_CODING:
        if (cdc_line_coding_done != 0U)
        {
          cdc_state = CDC_STATE_SET_CONTROL_LINE;
        }
        else if ((HAL_GetTick() - cdc_line_coding_start_tick) > CDC_LINE_CODING_TIMEOUT_MS)
        {
          printf("[WARN] CDC SetLineCoding timeout, proceeding\r\n");
          cdc_state = CDC_STATE_SET_CONTROL_LINE;
        }
        break;

      case CDC_STATE_SET_CONTROL_LINE:
      {
        USBH_StatusTypeDef st = CDC_SetControlLineState(&hUsbHostFS, CDC_CTRL_LINE_DTR_RTS);
        if (st != USBH_BUSY)
        {
          cdc_state = CDC_STATE_START_RECEPTION;
        }
        break;
      }

      case CDC_STATE_START_RECEPTION:
        if (USBH_CDC_Receive(&hUsbHostFS, cdc_rx_buf, CDC_RX_BUF_SIZE) == USBH_OK)
        {
          cdc_last_rx_tick = HAL_GetTick();
          cdc_state = CDC_STATE_RUNNING;
        }
        break;

      case CDC_STATE_RUNNING:
        if ((HAL_GetTick() - cdc_last_rx_tick) > CDC_RX_TIMEOUT_MS)
        {
          printf("[WARN] CDC RX timeout, re-arming reception\r\n");
          cdc_state = CDC_STATE_START_RECEPTION;
        }
        break;

      default:
        cdc_state = CDC_STATE_IDLE;
        break;
    }
  }
  else
  {
    cdc_state = CDC_STATE_IDLE;
    cdc_rx_ready = 0U;
    cdc_line_coding_done = 0U;
  }
}

/**
  * @brief  SET_CONTROL_LINE_STATE class request (DTR | RTS), needed by the
  *         CH340 before it forwards data.
  */
static USBH_StatusTypeDef CDC_SetControlLineState(USBH_HandleTypeDef *phost, uint16_t state)
{
  phost->Control.setup.b.bmRequestType = USB_H2D | USB_REQ_TYPE_CLASS | USB_REQ_RECIPIENT_INTERFACE;
  phost->Control.setup.b.bRequest = CDC_REQ_SET_CONTROL_LINE_STATE;
  phost->Control.setup.b.wValue.w = state;
  phost->Control.setup.b.wIndex.w = 0x0000U;
  phost->Control.setup.b.wLength.w = 0U;

  return USBH_CtlReq(phost, NULL, 0U);
}

void USBH_CDC_LineCodingChanged(USBH_HandleTypeDef *phost)
{
  (void)phost;
  cdc_line_coding_done = 1U;
}

void USBH_CDC_ReceiveCallback(USBH_HandleTypeDef *phost)
{
  uint16_t len = USBH_CDC_GetLastReceivedDataSize(phost);

  if (len > 0U)
  {
    cdc_last_rx_tick = HAL_GetTick();
    cdc_rx_ready = 1U;
    IMU_ParseStream(cdc_rx_buf, len);
  }

  if (USBH_CDC_Receive(phost, cdc_rx_buf, CDC_RX_BUF_SIZE) != USBH_OK)
  {
    cdc_state = CDC_STATE_START_RECEPTION;
    cdc_rx_ready = 0U;
  }
}

/**
  * @brief  Poll the on-board REC button K3 (PA15, active low, 100 nF to GND
  *         on the board). Sampled every 20 ms, 3 identical samples required
  *         (60 ms debounce); a stable press toggles SD recording.
  */
static void rec_switch_poll(void)
{
  static uint32_t last_tick = 0u;
  static uint8_t  raw_history = 0xFFu;   /* bit0 = latest sample, 1 = released */
  static uint8_t  stable_state = 1u;     /* debounced state, 1 = released    */

  if ((HAL_GetTick() - last_tick) < 20u)
  {
    return;
  }
  last_tick = HAL_GetTick();

  raw_history = (uint8_t)((raw_history << 1) |
      ((HAL_GPIO_ReadPin(REC_SW_GPIO_Port, REC_SW_Pin) != GPIO_PIN_RESET) ? 1u : 0u));

  if ((raw_history & 0x07u) == 0x00u)
  {
    if (stable_state != 0u)
    {
      stable_state = 0u;   /* debounced press edge: toggle recording */
      if (Recorder_IsActive() != 0u)
      {
        Recorder_Stop();
      }
      else
      {
        Recorder_Start();
      }
    }
  }
  else if ((raw_history & 0x07u) == 0x07u)
  {
    stable_state = 1u;
  }
}

/**
  * @brief  TIM3 update (2000 Hz): bump the global sample sequence number and
  *         start a conversion on both AD7606 chips.
  */
void HAL_TIM_PeriodElapsedCallback(TIM_HandleTypeDef *htim)
{
  if (htim->Instance == TIM3)
  {
    g_sample_seq++;
    AD7606_StartConversion();
  }
}

/**
  * @brief  AD7606 BUSY falling edge: conversion finished. Read all 16
  *         channels right here (~120 us) and push the raw sample into the
  *         SD recorder ring, so no sample is lost while the main loop is
  *         busy with a FatFs/SDIO write. Both chips convert on the same
  *         CONVST pulse, so the chip #1 BUSY edge covers both.
  */
void HAL_GPIO_EXTI_Callback(uint16_t GPIO_Pin)
{
  if (GPIO_Pin == AD1_BUSY_Pin)
  {
    AD7606_ReadAll((int16_t *)g_adc_values);
    /* SD receives the untouched raw ADC frame.  Filtering is only for the
       expanded USART telemetry frame and never changes g_adc_values. */
    Recorder_PushAdc(g_sample_seq, g_adc_values);
    EMG_Filter_Process(g_adc_values, g_emg_filtered_volts);
    g_new_sample = 1u;
  }
}

/**
  * @brief  Raw IMU frame hook (overrides the weak one in imu_parser.c):
  *         log the untouched 26-byte payload with the current ADC tick.
  */
void IMU_RawFrameHook(uint8_t device_id, const uint8_t *payload, uint16_t len)
{
  if (len == 26u)
  {
    Recorder_PushImu(g_sample_seq, device_id, payload);
  }
}

void HAL_UARTEx_RxEventCallback(UART_HandleTypeDef *huart, uint16_t Size)
{
  if (huart->Instance == USART1)
  {
    Cmd_RxEvent(Size);
  }
}

void HAL_UART_TxCpltCallback(UART_HandleTypeDef *huart)
{
  if (huart->Instance == USART1)
  {
    Serial_TxCpltHandler();
  }
}

void HAL_UART_ErrorCallback(UART_HandleTypeDef *huart)
{
  if (huart->Instance == USART1)
  {
    Cmd_RxError();
  }
}
/* USER CODE END 4 */
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
