junfoot/STM32F407_Muscle/Ref_project/STM32F407_9011RF/Core/Src/usart.c

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
/* Includes ------------------------------------------------------------------*/
#include "usart.h"

UART_HandleTypeDef huart1;

/* USART1 init function */

void MX_USART1_UART_Init(void)
{

  huart1.Instance = USART1;
  huart1.Init.BaudRate = 460800;
  huart1.Init.WordLength = UART_WORDLENGTH_8B;
  huart1.Init.StopBits = UART_STOPBITS_1;
  huart1.Init.Parity = UART_PARITY_NONE;
  huart1.Init.Mode = UART_MODE_TX_RX;
  huart1.Init.HwFlowCtl = UART_HWCONTROL_NONE;
  huart1.Init.OverSampling = UART_OVERSAMPLING_16;
  if (HAL_UART_Init(&huart1) != HAL_OK)
  {
    Error_Handler();
  }
}

void HAL_UART_MspInit(UART_HandleTypeDef* uartHandle)
{

  GPIO_InitTypeDef GPIO_InitStruct = {0};
  if(uartHandle->Instance==USART1)
  {
    /* USART1 clock enable */
    __HAL_RCC_USART1_CLK_ENABLE();

    __HAL_RCC_GPIOA_CLK_ENABLE();
    /**USART1 GPIO Configuration
    PA9     ------> USART1_TX
    PA10     ------> USART1_RX
    */
    GPIO_InitStruct.Pin = GPIO_PIN_9|GPIO_PIN_10;
    GPIO_InitStruct.Mode = GPIO_MODE_AF_PP;
    GPIO_InitStruct.Pull = GPIO_NOPULL;
    GPIO_InitStruct.Speed = GPIO_SPEED_FREQ_VERY_HIGH;
    GPIO_InitStruct.Alternate = GPIO_AF7_USART1;
    HAL_GPIO_Init(GPIOA, &GPIO_InitStruct);

  }
}

void HAL_UART_MspDeInit(UART_HandleTypeDef* uartHandle)
{

  if(uartHandle->Instance==USART1)
  {
    /* Peripheral clock disable */
    __HAL_RCC_USART1_CLK_DISABLE();

    /**USART1 GPIO Configuration
    PA9     ------> USART1_TX
    PA10     ------> USART1_RX
    */
    HAL_GPIO_DeInit(GPIOA, GPIO_PIN_9|GPIO_PIN_10);

  }
}

/* USER CODE BEGIN 1 */
#include <stdio.h>

#ifdef __GNUC__
  /* GCC / STM32CubeIDE: _write in syscalls.c calls __io_putchar */
  int __io_putchar(int ch)
  {
    HAL_UART_Transmit(&huart1, (uint8_t *)&ch, 1, 0xFFFF);
    return ch;
  }
#else
  /* Keil ARMCC / ARMClang retarget when MicroLIB is not used */
  #if defined(__ARMCC_VERSION) && (__ARMCC_VERSION >= 6000000)
    __asm(".global __use_no_semihosting\n");
  #else
    #pragma import(__use_no_semihosting)
  #endif

  #include <rt_sys.h>

  struct __FILE { int handle; };
  FILE __stdout;
  FILE __stdin;

  int fputc(int ch, FILE *f)
  {
    (void)f;
    HAL_UART_Transmit(&huart1, (uint8_t *)&ch, 1, 0xFFFF);
    return ch;
  }

  int _sys_write(int fh, const unsigned char *buf, unsigned len, int mode)
  {
    (void)fh;
    (void)mode;
    HAL_UART_Transmit(&huart1, (uint8_t *)buf, len, 0xFFFF);
    return (int)len;
  }

  void _ttywrch(int ch)
  {
    HAL_UART_Transmit(&huart1, (uint8_t *)&ch, 1, 0xFFFF);
  }

  void _sys_exit(int return_code)
  {
    (void)return_code;
    while (1) { }
  }
#endif
/* USER CODE END 1 */
