junfoot/STM32F407_Muscle/Core/Inc/dac8563.h

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
#ifndef __DAC8563_H__
#define __DAC8563_H__

#ifdef __cplusplus
extern "C" {
#endif

#include "main.h"

#define DAC8563_CH_A     0u
#define DAC8563_CH_B     1u
#define DAC8563_CH_BOTH  2u

#define DAC8563_VMIN     (0.0f)
#define DAC8563_VMAX     (10.0f)

void DAC8563_Init(void);
void DAC8563_SetOutput(uint8_t channel, uint16_t value);
void DAC8563_SetVoltage(uint8_t channel, float volts);

/**
  * @brief  Last commanded output voltage of a channel (for telemetry).
  * @param  channel  DAC8563_CH_A or DAC8563_CH_B
  */
float DAC8563_GetVoltage(uint8_t channel);

#ifdef __cplusplus
}
#endif

#endif /* __DAC8563_H__ */
