junfoot/STM32F407_Muscle/(commit log)

2026-09-18 feat: 双AD7606同步采样(2000Hz,±5V) + DAC8562输出 + USART1二进制协议
    - TIM3 2000Hz 触发,两片AD7606共用CONVST脉冲实现16通道同步采样
    - BUSY下降沿EXTI触发,主循环读取,USART1(921600)DMA实时发送38字节二进制帧
    - USART1中断接收指令帧(55 AA 01 ch vH vL sum)设置DAC8562输出
    - DAC8562软件SPI驱动,使能内部基准,0~5V输出
    - 同步更新CubeMX .ioc与MDK工程文件
2026-09-18 feat: 补充1 - printf重定向USART1、DAC8563(±10V)、4路IMU集成与JustFloat数据流
    - printf经serial.c的DMA环形缓冲(4KB)重定向到USART1, 全程非阻塞, 满则丢弃计数
    - USART1波特率921600->5250000(APB2=84MHz整除,0误差), 承载164B/帧@2000Hz
    - 上行数据改为VOFA+ JustFloat: 16路ADC电压(float) + 4颗IMU各[roll,pitch,yaw,ax,ay,az],
    帧尾00 00 80 7F; IMU数据在两帧之间保持(同步到2000Hz)
    - DAC8562驱动改为安富莱DAC8563模块, 输出映射±10V(0x8000=0V), 新增SetVoltage API
    - 串口指令改为字符串形式(以CR/LF结尾): DAC <A|B|AB> <volts> / DACR <ch> <code> / IMU / HELP
    - 移植9011RF参考工程的USB Host CDC(PA11/PA12, OTG_FS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
2026-09-18 feat: SD卡记录EMG+IMU原始数据, 串口921600/200Hz
    - SDIO 4bit(PC8-PC12+PD2, 24MHz, 轮询模式) + FatFs R0.12c, 上电自动建LOGxxxx.BIN
    - 记录格式: 32B文件头(EMGL+版本+通道数+采样率+IMU数), ADC记录0xA1+seq+16xint16(37B),
    IMU记录0xB1+seq+id+26B原始载荷(32B); seq为2000Hz全局采样计数, 两类记录共同时基
    - AD7606读取移入EXTI0中断并直接推入48KB环形缓冲(约650ms数据), FatFs阻塞写不再丢采样;
    溢出计数可用REC指令查询
    - imu_parser增加IMU_RawFrameHook弱钩子, main.c覆写用于记录原始帧
    - 新增指令: REC / REC START / REC STOP; f_sync每2s, STOP时完整冲刷关文件
    - USART1波特率回921600; JustFloa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
2026-09-19 feat: PA4按键(S2)控制SD记录启停, PA1 LED指示记录状态
    - 依据原理图V2.8: PA4按键接GND(内部上拉,低有效), 主循环20ms轮询+60ms消抖,
    稳定按下沿切换Recorder_Start/Stop; PA1 LED为VCC->D2->1.5K->PA1(低电平点亮),
    亮=正在写入(跟随Recorder_IsActive, 含自动重试失败的真实状态)
    - DAC_DIN由PA4迁至PA0: PA4在V2.8上是板载按键且线上有C13(100nF),
    与DAC数据无法复用; PA0在旧引脚清单未用、V2.8仅为排针。DAC其余引脚不变,
    驱动仍写GPIOA BSRR,无需改动
    - 同步更新.ioc(PA0=DAC_DIN输出, PA1=REC_LED输出置高, PA4=REC_SW上拉输入)
2026-09-19 fix: DAC_DIN恢复PA4, 记录按键迁至PA15(K3); 无SD卡/USB时可靠运行
    - DAC_DIN改回PA4(不再占用PA0); 按键改用原理图V2.8的K3(PA15->S3->GND,
    内部上拉,低有效), 消抖/切换逻辑不变; PA1 LED指示不变
    - PA15为JTDI复用脚: F4无F1式SWJ重映射, 配成输入即脱离JTDI, SWD(PA13/14)不受影响
    - 无SD卡: SDIO命令有硬件CTIMEOUT(~64个SDIOCLK)与5s计数上限, 挂载快速失败,
    记录器每5s自动重试, 主循环不阻塞; rec_open_next_file遇FR_EXIST以外的
    FatFs错误立即放弃并卸载, 不再盲扫1万个文件名
    - 无USB接收器: USBH_Process无设备时空转, CDC状态机不复位主流程, 无阻塞
    [STM32F407_Muscle.ioc, main.c, main.h]
2026-09-19 feat: 串口首行输出SD卡/USB接收器在位状态
    - 上电第一条串口输出: [BOOT] SD=x USB=x (1=在位,0=缺失), 其后才是常规banner
    - SD探测: Recorder_Init改为静默挂载尝试并返回结果(打印移至REC START/自动重试成功路径)
    - USB探测: 给USB Host一个有界2s枚举窗口(此间TIM3尚未启动, 不影响采样),
    设备枚举成功(APPLICATION_READY)即认为接收器在位; 未插则2s后照常启动
2026-09-19 feat: JustFloat帧最前面加入SD/USB状态与DAC输出, 帧率降100Hz
    - 帧布局改为43通道: [0]=SD/USB状态(bit0=SD记录中, bit1=USB接收器就绪, 单值0-3),
    [1..2]=DAC A/B输出电压, [3..18]=16路ADC电压, [19..42]=4颗IMU(角度+加速度),
    帧尾00 00 80 7F不变; 串口帧率2000/20=100Hz, 921600下占空约19%
    - 热插拔实时: SD状态跟随Recorder_IsActive(拔出时写错误即时检出, 插入2s内自动恢复记录),
    USB状态跟随Appli_state(枚举/断开由USB Host自动上报)
    - DAC8563驱动记录最近输出码, 新增DAC8563_GetVoltage()供遥测
    - 移除上一版的[BOOT]开机状态行与2s枚举等待(状态已进数据流, 开机不再延迟)
2026-09-19 feat: 复位时打印一次SD/USB在位状态
    - 复位后串口首行: [BOOT] SD=x USB=x (1=present); 数据流ch0的实时状态保留不变
    - USB探测用有界2s枚举窗口(TIM3采样尚未启动, 无数据损失), 未插则2s后照常启动
2026-09-19 chore: 纳入参考工程STM32F407_9011RF(IMU/USB Host移植来源, 存档用)
2026-09-19 fix: 修复SD卡检测卡死并改用DMA传输
2026-09-19 fix: 修正SD记录按键与LED状态控制
2026-09-19 docs: 补充串口显示与SD记录控制需求
2026-09-19 feat: 完善设备状态检测与采集控制
2026-09-19 fix: 使用DMA提高串口命令接收可靠性
2026-09-19 feat: add SD card data parser and validation outputs
    [LOG0002_adc.csv, LOG0002_imu.csv, LOG0002_summary.csv, LOG0006_adc.csv, LOG0006_imu.csv, LOG0006_summary.csv, all_logs_summary.csv]
2026-09-19 chore: organize reference projects
    [ALIGNED0001.csv, ALIGNED0002.csv, ALIGNED0004.csv, ALIGNED0006.csv, EMG0001.csv, EMG0002.csv, EMG0003.csv, EMG0004.csv]
2026-09-21 feat: add filtered telemetry and serial parser
    [serial_telemetry.csv]
2026-09-21 chore: ignore generated SD data
    [ALIGNED0001.csv, ALIGNED0002.csv, ALIGNED0004.csv, ALIGNED0006.csv, EMG0001.csv, EMG0002.csv, EMG0003.csv, EMG0004.csv]
2026-09-21 fix: correct AD7606 serial timing and document ±5V range
