junfoot/STM32F407_Muscle/Ref_project/STM32F407VET6_ADS1292/STM32开发板照片.jpg

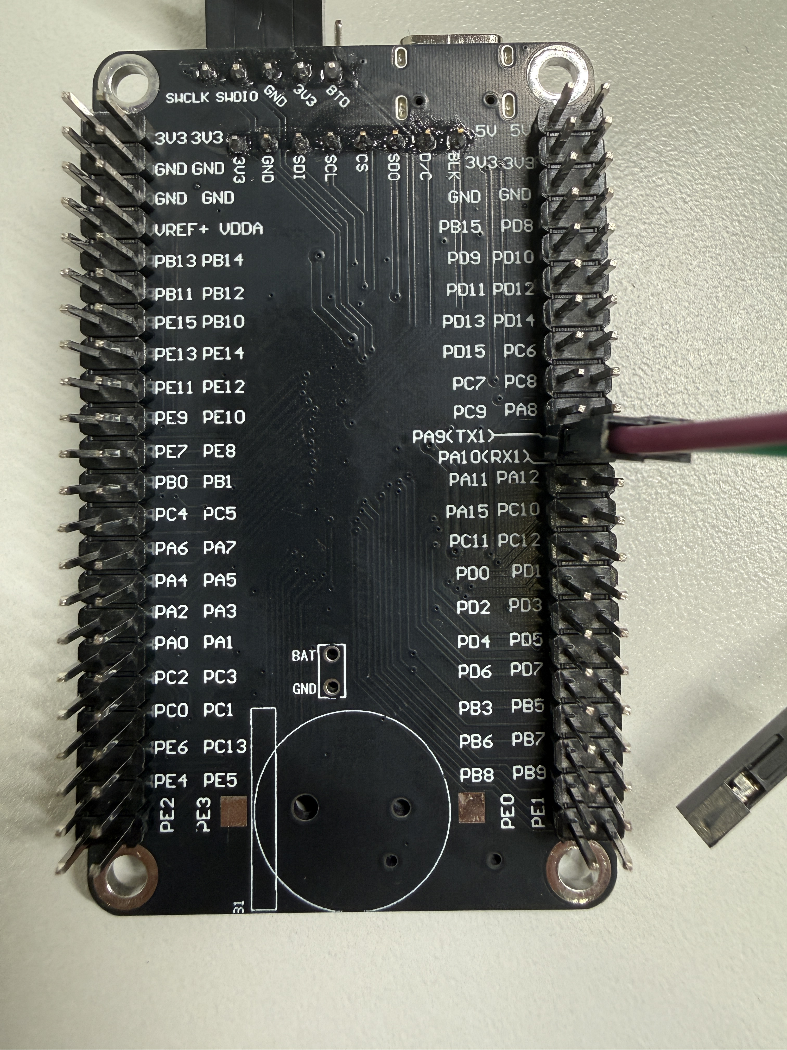
Ref_project/STM32F407VET6_ADS1292/STM32开发板照片.jpg
